awesomebrick/fieldbox/README.md

# fieldbox
Senior design project. FPGA-powered eurorack synthesis and audio processing module
