awesomebrick/fieldbox/hardware/motherboard_pcb/fieldbox/diagram.pdf

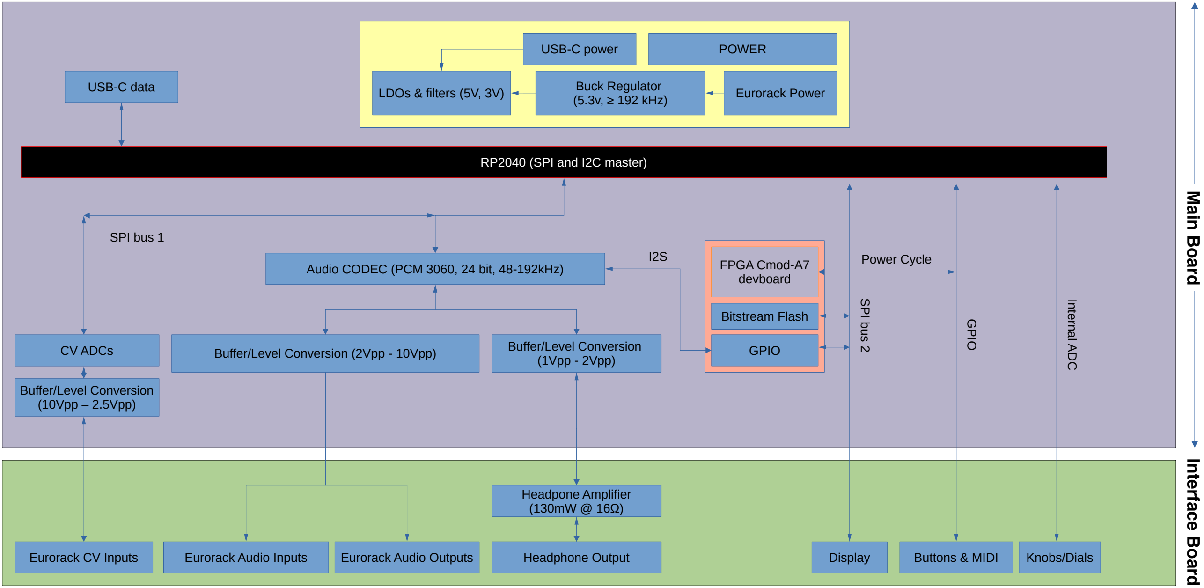
[picture p1: figure]
FPGA Cmod-A7 devboard; GPIO; Bitstream Flash; CV ADCs; Eurorack CV Inputs; Eurorack Audio Inputs; Eurorack Audio Outputs; Headphone Output; Headpone Amplifier (130mW @ 16Ω); USB-C power; Buck Regulator (5.3v, ≥ 192 kHz); LDOs & filters (5V, 3V); USB-C data; Eurorack Power; POWER; Buffer/Level Conversion (1Vpp - 2Vpp); Buffer/Level Conversion (2Vpp - 10Vpp); Display; Buttons & MIDI; Buffer/Level Conversion (10Vpp – 2.5Vpp); RP2040 (SPI and I2C master); SPI bus 1; G PIO; Knobs/Dials; t ern; Power Cycle; M ain

Audio CODEC (PCM 3060, 24 bit, 48-192kHz)
