awesomebrick/fieldbox/hardware/motherboard_pcb/fieldbox/fieldbox.ods

Id | Designator | Footprint | Quantity | Designation | Supplier and ref
1 | R35,R46,R43,R49,R42,R50 | R_0603_1608Metric | 6 | 12k
2 | D1,D2,D5 | D_SMA | 3 | SK34SMA-3G
3 | U2,U23,U18,U21,U1 | TSSOP-14_4.4x5mm_P0.65mm | 5 | TL074
4 | U4 | HTSOP-8-1EP_3.9x4.9mm_P1.27mm_EP2.4x3.2mm | 1 | BD9D321EFJ-E2
5 | C51,C43,C45,C55,C26,C54,C47,C56,C46,C44,C7,C11,C37,C32,C40,C57,C4,C1,C60,C50 | C_0603_1608Metric | 20 | 100nF
6 | D3,D4,D23,D22,D20,D21,D16,D13,D15,D10,D19,D18,D12,D11,D17,D14 | D_SOD-323F | 16 | 1N4148
7 | C66,C64,C23,C21,C39,C30,C53,C31,C34,C27,C62,C28,C61,C38,C35 | C_0603_1608Metric | 15 | 1uF
8 | R20,R16,R13,R10 | R_0603_1608Metric | 4 | 330
9 | C6,C5 | CP_EIA-3216-18_Kemet-A | 2 | 4.7uF
10 | J2 | PinSocket_1x06_P2.54mm_Vertical | 1 | Conn_01x06_Socket
11 | R21,R22,R39 | R_0603_1608Metric | 3 | 1k
12 | U16 | SOIC-8_5.3x5.3mm_P1.27mm | 1 | W25Q16JVSNIM
13 | R23,R52,R40,R31,R32,R24,R41,R51 | R_0603_1608Metric | 8 | 33k
14 | D6,D9,D8,D7 | LED_0603_1608Metric | 4 | RED
15 | R57,R73,R74,R76,R56 | C_0603_1608Metric | 5 | 30k
16 | U20 | TSSOP-20_4.4x6.5mm_P0.65mm | 1 | MCP3462R
17 | U13,U15,U5 | SOT-23-5 | 3 | AP22814BW5
18 | R7 | R_0603_1608Metric | 1 | 330k .1%
19 | R54,R60,R66,R26,R45,R55,R37,R30,R33,R28,R64,R36,R65,R44,R48,R78,R61,R53,R75 | R_0603_1608Metric | 19 | 100k
20 | R83,R80 | R_0603_1608Metric | 2 | 5.62k
21 | C17,C18 | C_0603_1608Metric | 2 | 22uF
22 | U3 | TSSOP-28_4.4x9.7mm_P0.65mm | 1 | PCM3060
23 | R59,R2,R11,R15,R1,R85,R77,R9,R8 | R_0603_1608Metric | 9 | 10k
24 | C16,C14,C12,C20 | C_0603_1608Metric | 4 | 100nF 12v
25 | R6 | R_0603_1608Metric | 1 | 220k .1%
26 | R81,R82,R84,R79 | R_0603_1608Metric | 4 | 2.87k
27 | FB3,FB1,FB2 | L_0603_1608Metric | 3 | MFBM1V1608-600-R
28 | C65,C8,C2,C63,C3,C10,C58,C9 | CP_EIA-3216-18_Kemet-A | 8 | 10uF
29 | C19,C13,C15,C29,C24 | CP_EIA-3528-21_Kemet-B | 5 | 22uF 12v
30 | J1 | PinSocket_1x06_P2.54mm_Vertical | 1 | Conn_01x04_Socket
31 | U27 | OSC-SMD_4P-L2.5-W2.0-BL_ABRACON_ASTMLPD | 1 | ASDDV-12.000MHZ-LC-T
32 | R4,R25,R3 | R_0603_1608Metric | 3 | 10k .1%
33 | J5 | PinSocket_1x04_P2.54mm_Vertical | 1 | Conn_01x04_Socket
34 | R12 | R_0603_1608Metric | 1 | 10.5k
35 | U25 | TSSOP-16-1EP_4.4x5mm_P0.65mm_EP3x3mm | 1 | MAX9722A
36 | R58,R34 | R_0603_1608Metric | 2 | 47.5k
37 | J3 | PinSocket_1x11_P2.54mm_Vertical | 1 | Conn_01x11_Socket
38 | U11 | SON50P250X250X80-11N-D | 1 | TPS7A91
39 | C33 | C_0603_1608Metric | 1 | 100pF
40 | L1 | L_APV_ANR4012 | 1 | 3.3uH
41 | R17,R18 | R_0603_1608Metric | 2 | 27.4
42 | APS6408L-30Cx1 | BGA-24_6x8mm_Layout5x5_P1.0mm | 1 | ~
43 | U19,U22 | DIP-6_W7.62mm | 2 | H11L1M
44 | C22 | C_0603_1608Metric | 1 | 3.3nF
45 | U9,U8 | SOT-23-5 | 2 | AP22814AW5
46 | U10,U26 | SOT-353_SC-70-5 | 2 | 74LVC1G32
47 | U7 | SOT-363_SC-70-6 | 1 | NC7SZ332
48 | JP4 | R_0603_1608Metric | 1 | Jumper_2_Open
49 | U24 | MSOP-8_3x3mm_P0.65mm | 1 | MCP6282
50 | C36,C25 | CP_EIA-3528-21_Kemet-B | 2 | 120uF
51 | U14 | QSOP-20_3.9x8.7mm_P0.635mm | 1 | QS3VH245
52 | R27,R29 | R_0603_1608Metric | 2 | 20k .1%
53 | R38,R47 | R_0603_1608Metric | 2 | 220
54 | U17 | QFN-56-1EP_7x7mm_P0.4mm_EP3.2x3.2mm | 1 | RP2040
55 | U12 | SOIC-8_3.9x4.9mm_P1.27mm | 1 | AP2213M
56 | R5 | R_0603_1608Metric | 1 | 22k .1%
57 | R14 | R_0603_1608Metric | 1 | 2k
58 | U6 | Texas_X2QFN-12_1.6x1.6mm_P0.4mm | 1 | PTN5150A
59 | C41 | C_0603_1608Metric | 1 | .01uF
60 | cmod_a1 | CMOD-A7 | 1 | cmod a7 35t
61 | J4 | IDC-Header_2x05_P2.54mm_Vertical | 1 | Conn_02x05_Odd_Even
