awesomebrick/fieldbox/hardware/motherboard_pcb/fieldbox/try2.ods

Reference | Qty | Description | Mouser #
J1,J2,J3,J5,JP4 | 5 | Generic connector, single row, 01x04, script generated,Generic connector, single row, 01x06, script generated,Generic connector, single row, 01x11, script generated,Jumper, 2-pole, open
U17 | 1 | A microcontroller by Raspberry Pi | 358-SC091413
cmod_a1 | 1 |  | 424-410-328-35
U16 | 1 | 128Mbit / 16MiB Serial Flash Memory, Standard/Dual/Quad SPI, 2.7-3.6V, SOIC-8 | 454-W25Q16JVSNIM
U19,U22 | 2 | Schmitt Trigger Output Optocoupler, High Speed, DIP-6, 1.6mA turn on threshold | 512-H11L1M
U7 | 1 | Logic Gates TinyLogic UHS 3Input | 512-NC7SZ332P6X
C2,C3,C8,C9,C10,C58,C63,C65 | 8 |  | 581-TAJA106K016R
C5,C6 | 2 | Polarized capacitor | 581-TAJA475M006R
C13,C15,C19,C24,C29 | 5 | Polarized capacitor | 581-TAJB226K016TNJ
C25,C36 | 2 | Polarized capacitor | 581-TPSB107M006R0400
U1,U2,U18,U21,U23 | 5 | Quad Low-Noise JFET-Input Operational Amplifiers, DIP-14/SOIC-14 | 595-TL074HIPWR
U11 | 1 | 1A low noise high PSSR LDO | 595-TPS7A9101DSKR
C33 | 1 | Unpolarized capacitor | 603-CC603KRX7R8BB101
C41 | 1 | Unpolarized capacitor | 603-CC603ZRY5V8BB103
R10,R13,R16,R20 | 4 | Resistor | 603-RC0603FR-10330RL
R17,R18 | 2 | Resistor | 603-RC0603FR-0727R4L
U12 | 1 | 3.3v low noise ldo | 621-AP2213M-3.3TRG1
U8,U9 | 2 | Current limited 3A power switch, single channel, SOT-23-5 | 621-AP22814AW5-7
U5,U13,U15 | 3 | Current limited 3A power switch, single channel, SOT-23-5 | 621-AP22814BW5-7
D3,D4,D10,D11,D12,D13,D14,D15,D16,D17,D18,D19,D20,D21,D22,D23 | 16 | 100V 0.15A standard switching diode, DO-35 | 637-1N4148WS-AQ
D1,D2,D5 | 3 | Schottky diode | 637-SK34SMA-3G
R38,R47 | 2 | Resistor | 652-CR0603FX-2200ELF
R79,R81,R82,R84 | 4 | Resistor | 652-CR0603FX-2871ELF
R1,R2,R3,R4,R8,R9,R11,R15,R25,R59,R77,R85 | 12 | Resistor | 652-CRT0603BY1002ELF
R80,R83 | 2 | Resistor | 660-RK73H1JTTD5621F
R21,R22,R39 | 3 | Resistor | 660-RK73H1JTTDD1001F
R56,R57,R73,R74,R76 | 5 | Resistor | 660-RK73H1JTTDD3002F
R14 | 1 | Resistor | 660-RN73H1JTD2001B25
R12 | 1 | Resistor | 667-ERA-3AEB1052V
R34,R58 | 2 | Resistor | 667-ERA-3AEB4752V
U25 | 1 | MAX9722AEUE+T | 700-MAX9722AEUE
FB1,FB2,FB3 | 3 | Ferrite bead | 704-MFBM1V1608-600-R
R27,R29 | 2 | Resistor | 708-RNCF0603BTC20K0
D6,D7,D8,D9 | 4 | Light emitting diode | 720-LSQ976.01-N1Q2-1
J4 | 1 | Generic connector, double row, 02x05, odd/even pin numbering scheme (row 1 odd numbers, row 2 even numbers), script generated (kicad-library-utils/schlib/autogen/connector/) | 737-BHR-10-VUA
R35,R42,R43,R46,R49,R50 | 6 | Resistor | 754-RG1608P-123-B-T5
R5 | 1 | Resistor | 754-RG1608P-223-B-T5
R6 | 1 | Resistor | 754-RG1608P-224-BT5
R7 | 1 | Resistor | 754-RG1608P-334-B-T5
U4 | 1 |  | 755-BD9D321EFJ-E2
U10,U26 | 2 | Single OR Gate, Low-Voltage CMOS | 771-74LVC1G32GW-G
U6 | 1 |  | 771-PTN5150AHXMP
C21,C23,C27,C28,C30,C31,C34,C35,C38,C39,C53,C61,C62,C64,C66 | 15 | Unpolarized capacitor | 791-0201X105M6R3CT
C17,C18 | 2 | Unpolarized capacitor | 81-GRM188R60J226ME5J
U27 | 1 |  | 815-ASDDV-1200MHZLCT
APS6408L-30Cx1 | 1 |  | 878-APS6408L-3OC-BA
L1 | 1 | Inductor | 963-NRS4012T3R3MDGJ
U14 | 1 |  | 972-QS3VH245QG8
C22 | 1 | Unpolarized capacitor | CL10B332KB8NFNC
R26,R28,R30,R33,R36,R37,R44,R45,R48,R53,R54,R55,R60,R61,R64,R65,R66,R75,R78 | 19 | Resistor | CR0603-FX-1003ELF
R23,R24,R31,R32,R40,R41,R51,R52 | 8 | Resistor | CR0603-FX-3302ELF
C1,C4,C7,C11,C12,C14,C16,C20,C26,C32,C37,C40,C43,C44,C45,C46,C47,C50,C51,C54,C55,C56,C57,C60 | 24 | Unpolarized capacitor | KGM15AR71C104MM
U20 | 1 | Analog to Digital Converters - ADC 16-bit delta-sigma ADC w/Vref, Dual channel, 3V | MCP3462R-E/ST
U24 | 1 |  | MCP6282T-E/MS
U3 | 1 | 24-bit Asynchronous Stereo Audio Codec with 96/192kHz sampling rate, TSSOP-28 | PCM3060PWR
