awesomebrick/fieldbox/hardware/motherboard_pcb/fieldbox/fieldbox.kicad_pcb

## KiCad design hardware/motherboard_pcb/fieldbox/fieldbox.kicad_pcb (2026-04-05)

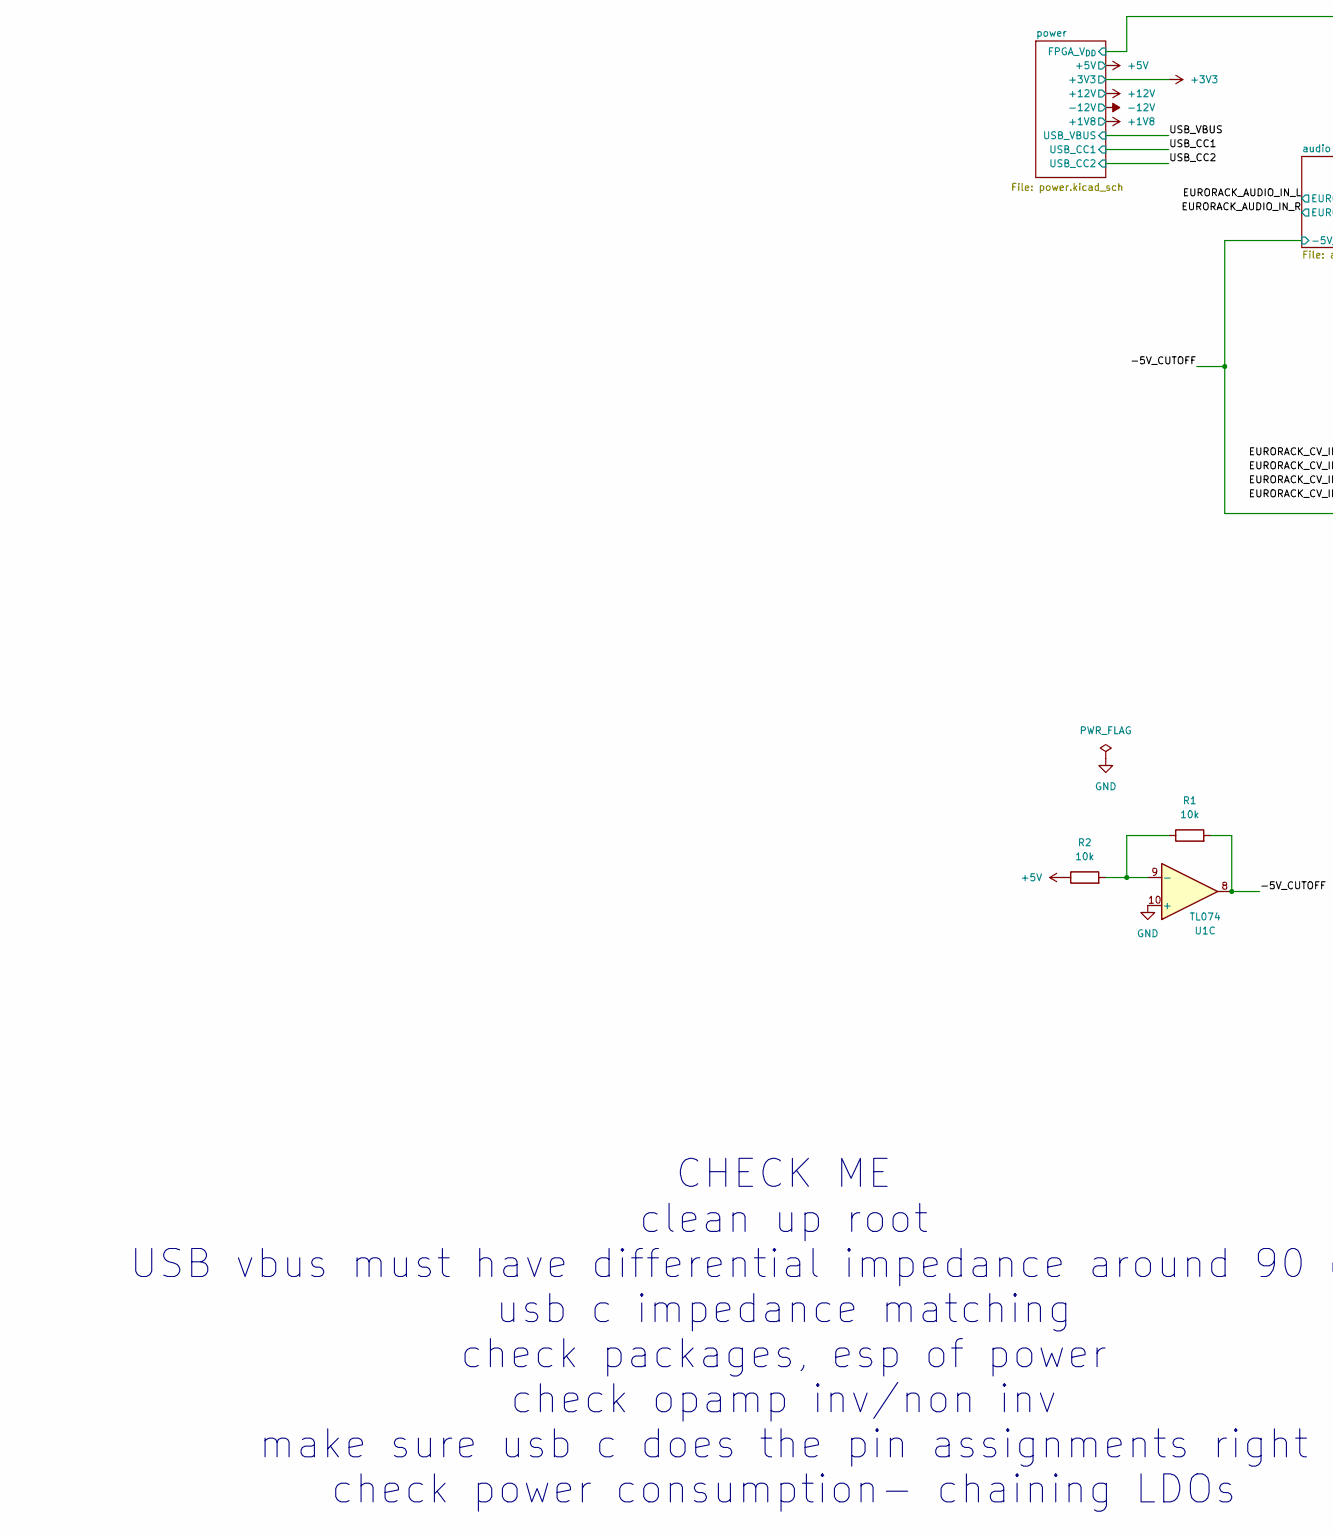
[picture p2: schematic fieldbox.kicad_sch, part in row 1, column 1]

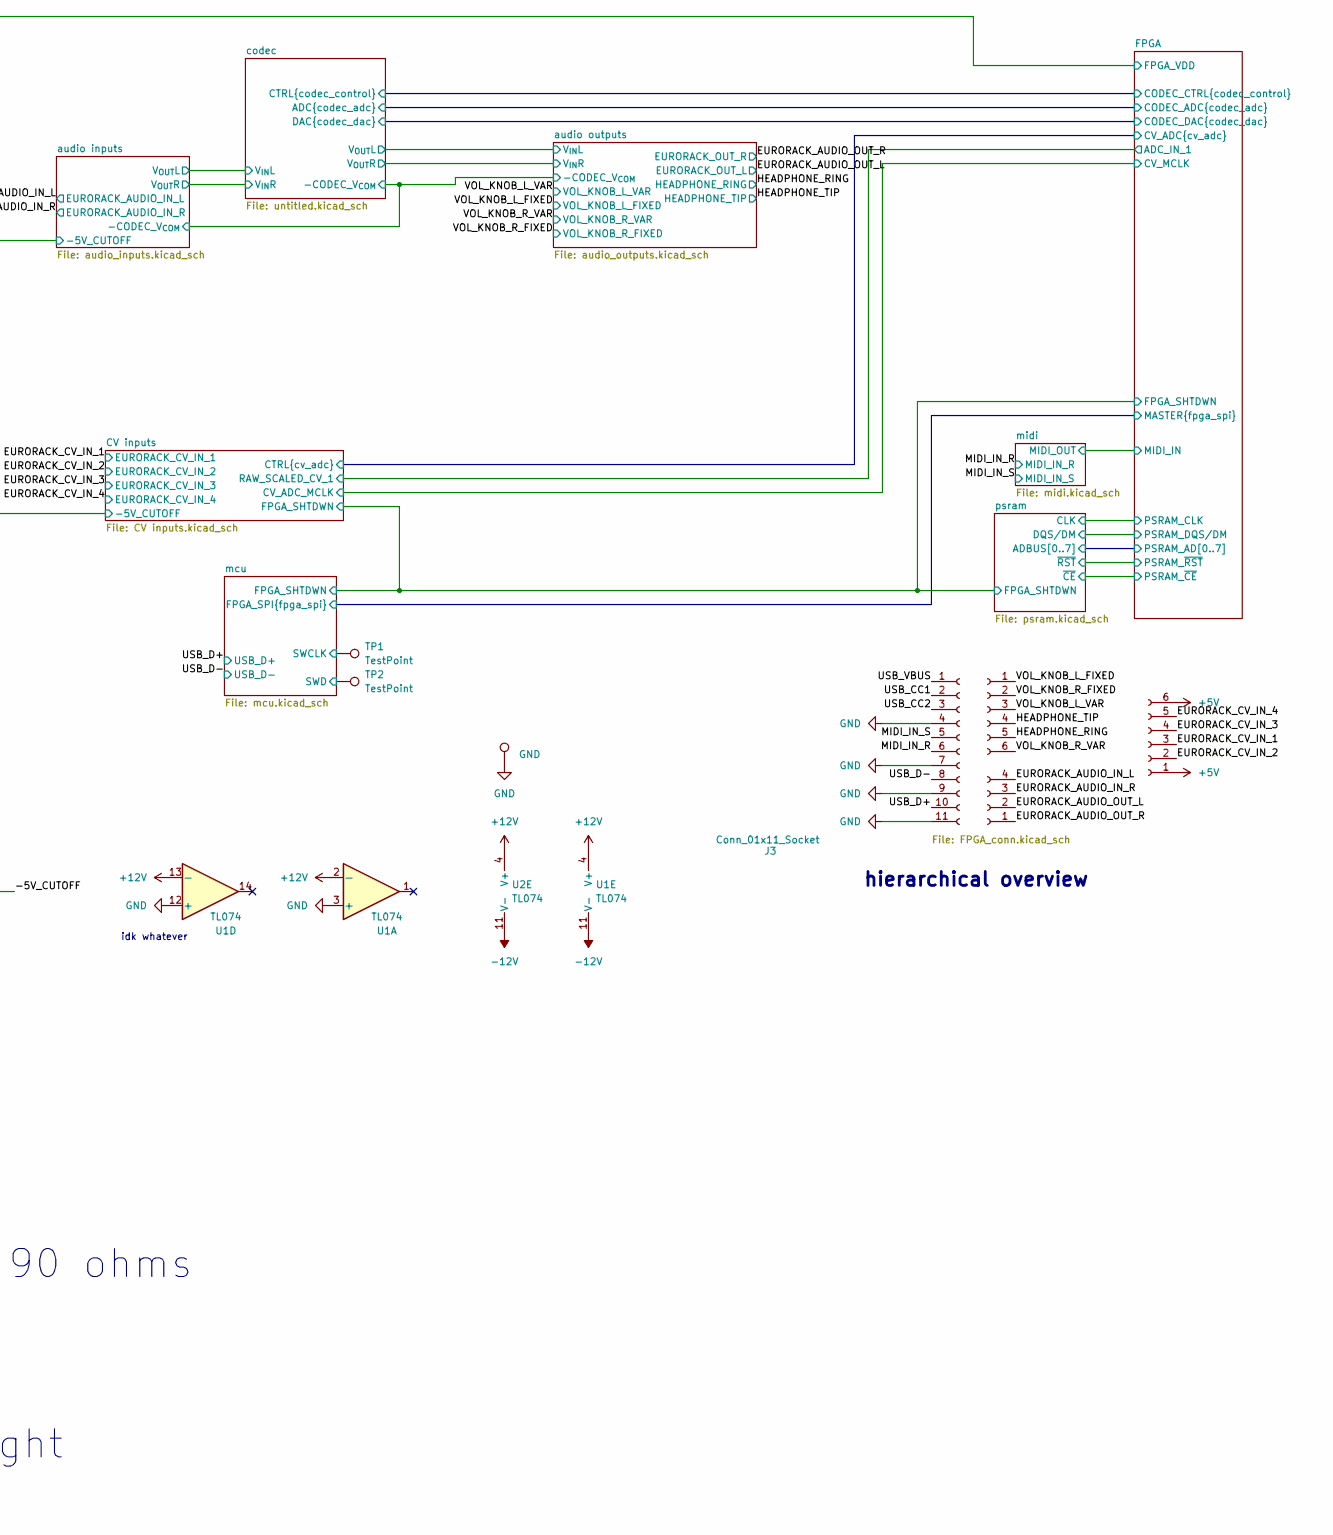
[picture p3: schematic fieldbox.kicad_sch, part in row 1, column 2]

Parts:
J1: Conn_01x04_Socket; PinSocket_1x06_P2.54mm_Vertical
J2: Conn_01x06_Socket; PinSocket_1x06_P2.54mm_Vertical
J3: Conn_01x11_Socket; PinSocket_1x11_P2.54mm_Vertical
J5: Conn_01x04_Socket; PinSocket_1x04_P2.54mm_Vertical
R1, R2: 10k; R_0603_1608Metric; Mouser # 652-CRT0603BY1002ELF
TP1, TP2: TestPoint; TestPoint_Pad_2.0x2.0mm; Mouser # NA
TP3: GND; TestPoint_Pad_D2.0mm; Mouser # NA
U1, U2: TL074; TSSOP-14_4.4x5mm_P0.65mm; Mouser # 595-TL074HIPWR

Connections:
+5V: J1.1, J1.6, R2.1; also elsewhere on the board
+12V: U1.2 (-), U1.4 (V+), U1.13 (-), U2.4 (V+); also elsewhere on the board
-12V: U1.11 (V-), U2.11 (V-); also elsewhere on the board
/-5V_CUTOFF: R1.2, U1.8; also elsewhere on the board
/EURORACK_AUDIO_IN_L: J5.4; also elsewhere on the board
/EURORACK_AUDIO_IN_R: J5.3; also elsewhere on the board
/EURORACK_AUDIO_OUT_L: J5.2; also elsewhere on the board
/EURORACK_AUDIO_OUT_R: J5.1; also elsewhere on the board
/EURORACK_CV_IN_1: J1.3; also elsewhere on the board
/EURORACK_CV_IN_2: J1.2; also elsewhere on the board
/EURORACK_CV_IN_3: J1.4; also elsewhere on the board
/EURORACK_CV_IN_4: J1.5; also elsewhere on the board
/HEADPHONE_RING: J2.5; also elsewhere on the board
/HEADPHONE_TIP: J2.4; also elsewhere on the board
/MIDI_IN_R: J3.6; also elsewhere on the board
/MIDI_IN_S: J3.5; also elsewhere on the board
/USB_CC1: J3.2; also elsewhere on the board
/USB_CC2: J3.3; also elsewhere on the board
/USB_D+: J3.10; also elsewhere on the board
/USB_D-: J3.8; also elsewhere on the board
/USB_VBUS: J3.1; also elsewhere on the board
/VOL_KNOB_L_FIXED: J2.1; also elsewhere on the board
/VOL_KNOB_L_VAR: J2.3; also elsewhere on the board
/VOL_KNOB_R_FIXED: J2.2; also elsewhere on the board
/VOL_KNOB_R_VAR: J2.6; also elsewhere on the board
/mcu/SWCLK: TP1.1; also elsewhere on the board
/mcu/SWD: TP2.1; also elsewhere on the board
GND: J3.4, J3.7, J3.9, J3.11, TP3.1, U1.3 (+), U1.10 (+), U1.12 (+); also elsewhere on the board
unnamed: R1.1, R2.2, U1.9 (-)

Notes on the sheet:
hierarchical overview
CHECK ME clean up root USB vbus must have differential impedance around 90 ohms usb c impedance matching check packages, esp of power check opamp inv/non inv make sure usb c does the pin assignments right check power consumption- chaining LDOs
idk whatever

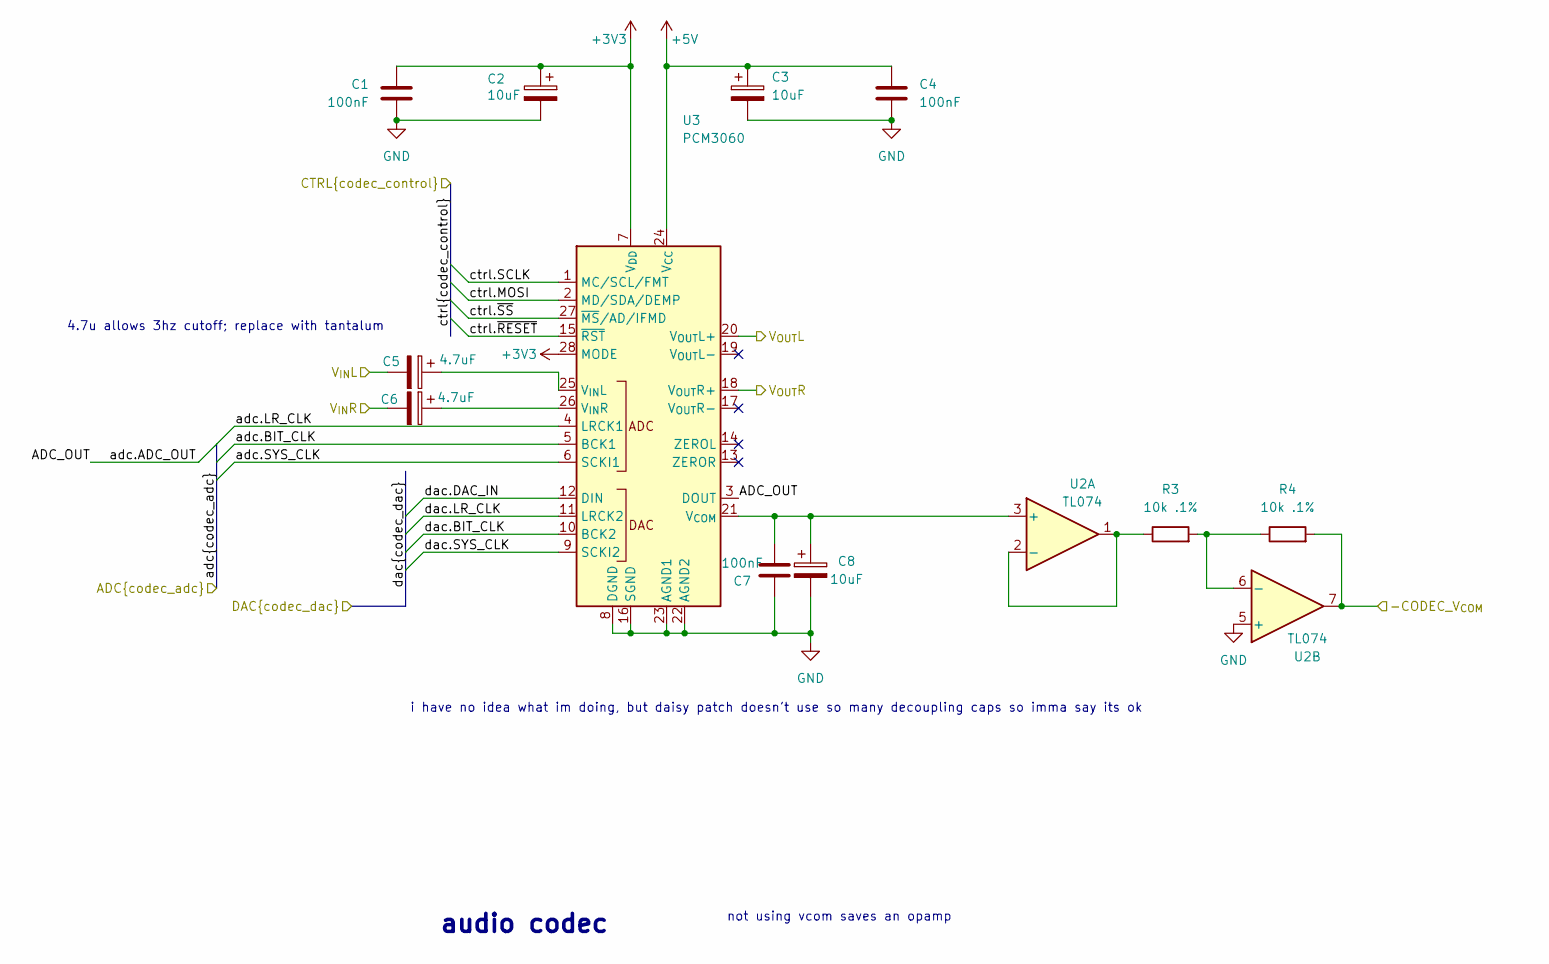
[picture p4: schematic untitled.kicad_sch]

Parts:
C1, C4, C7: 100nF; C_0603_1608Metric; Mouser # KGM15AR71C104MM
C2, C3, C8: 10uF; CP_EIA-3216-18_Kemet-A; Mouser # 581-TAJA106K016R
C5, C6: 4.7uF; CP_EIA-3216-18_Kemet-A; Mouser # 581-TAJA475M006R
R3, R4: 10k .1%; R_0603_1608Metric; Mouser # 652-CRT0603BY1002ELF
U2: TL074; TSSOP-14_4.4x5mm_P0.65mm; Mouser # 595-TL074HIPWR
U3: PCM3060; TSSOP-28_4.4x9.7mm_P0.65mm; Mouser # PCM3060PWR

Connections:
+3V3: C1.1, C2.1, U3.7 (V_{DD}), U3.28 (MODE); also elsewhere on the board
+5V: C3.1, C4.1, U3.24 (V_{CC}); also elsewhere on the board
/FPGA/CODEC_ADC.ADC_OUT: U3.3 (DOUT); also elsewhere on the board
/FPGA/CODEC_ADC.BIT_CLK: U3.5 (BCK1); also elsewhere on the board
/FPGA/CODEC_ADC.LR_CLK: U3.4 (LRCK1); also elsewhere on the board
/FPGA/CODEC_ADC.SYS_CLK: U3.6 (SCKI1); also elsewhere on the board
/FPGA/CODEC_CTRL.MOSI: U3.2 (MD/SDA/DEMP); also elsewhere on the board
/FPGA/CODEC_CTRL.SCLK: U3.1 (MC/SCL/FMT); also elsewhere on the board
/FPGA/CODEC_CTRL.~RESET: U3.15 (~RST); also elsewhere on the board
/FPGA/CODEC_CTRL.~SS: U3.27 (~MS/AD/IFMD); also elsewhere on the board
/FPGA/CODEC_DAC.BIT_CLK: U3.10 (BCK2); also elsewhere on the board
/FPGA/CODEC_DAC.DAC_IN: U3.12 (DIN); also elsewhere on the board
/FPGA/CODEC_DAC.LR_CLK: U3.11 (LRCK2); also elsewhere on the board
/FPGA/CODEC_DAC.SYS_CLK: U3.9 (SCKI2); also elsewhere on the board
/audio inputs/-CODEC_V_{COM}: R4.2, U2.7; also elsewhere on the board
/audio inputs/V_{OUT}L: C5.2; also elsewhere on the board
/audio inputs/V_{OUT}R: C6.2; also elsewhere on the board
/audio outputs/V_{IN}L: U3.20 (V_{OUT}L+); also elsewhere on the board
/audio outputs/V_{IN}R: U3.18 (V_{OUT}R+); also elsewhere on the board
GND: C1.2, C2.2, C3.2, C4.2, C7.1, C8.2, U2.5 (+), U3.8 (DGND), U3.16 (SGND), U3.22 (AGND2), U3.23 (AGND1); also elsewhere on the board
unnamed: C7.2, C8.1, U2.3 (+), U3.21 (V_{COM})
unnamed: R3.1, U2.1, U2.2 (-)
unnamed: R3.2, R4.1, U2.6 (-)
unnamed: C5.1, U3.25 (V_{IN}L)
unnamed: C6.1, U3.26 (V_{IN}R)

Notes on the sheet:
i have no idea what im doing, but daisy patch doesn't use so many decoupling caps so imma say its ok
4.7u allows 3hz cutoff; replace with tantalum
not using vcom saves an opamp
audio codec

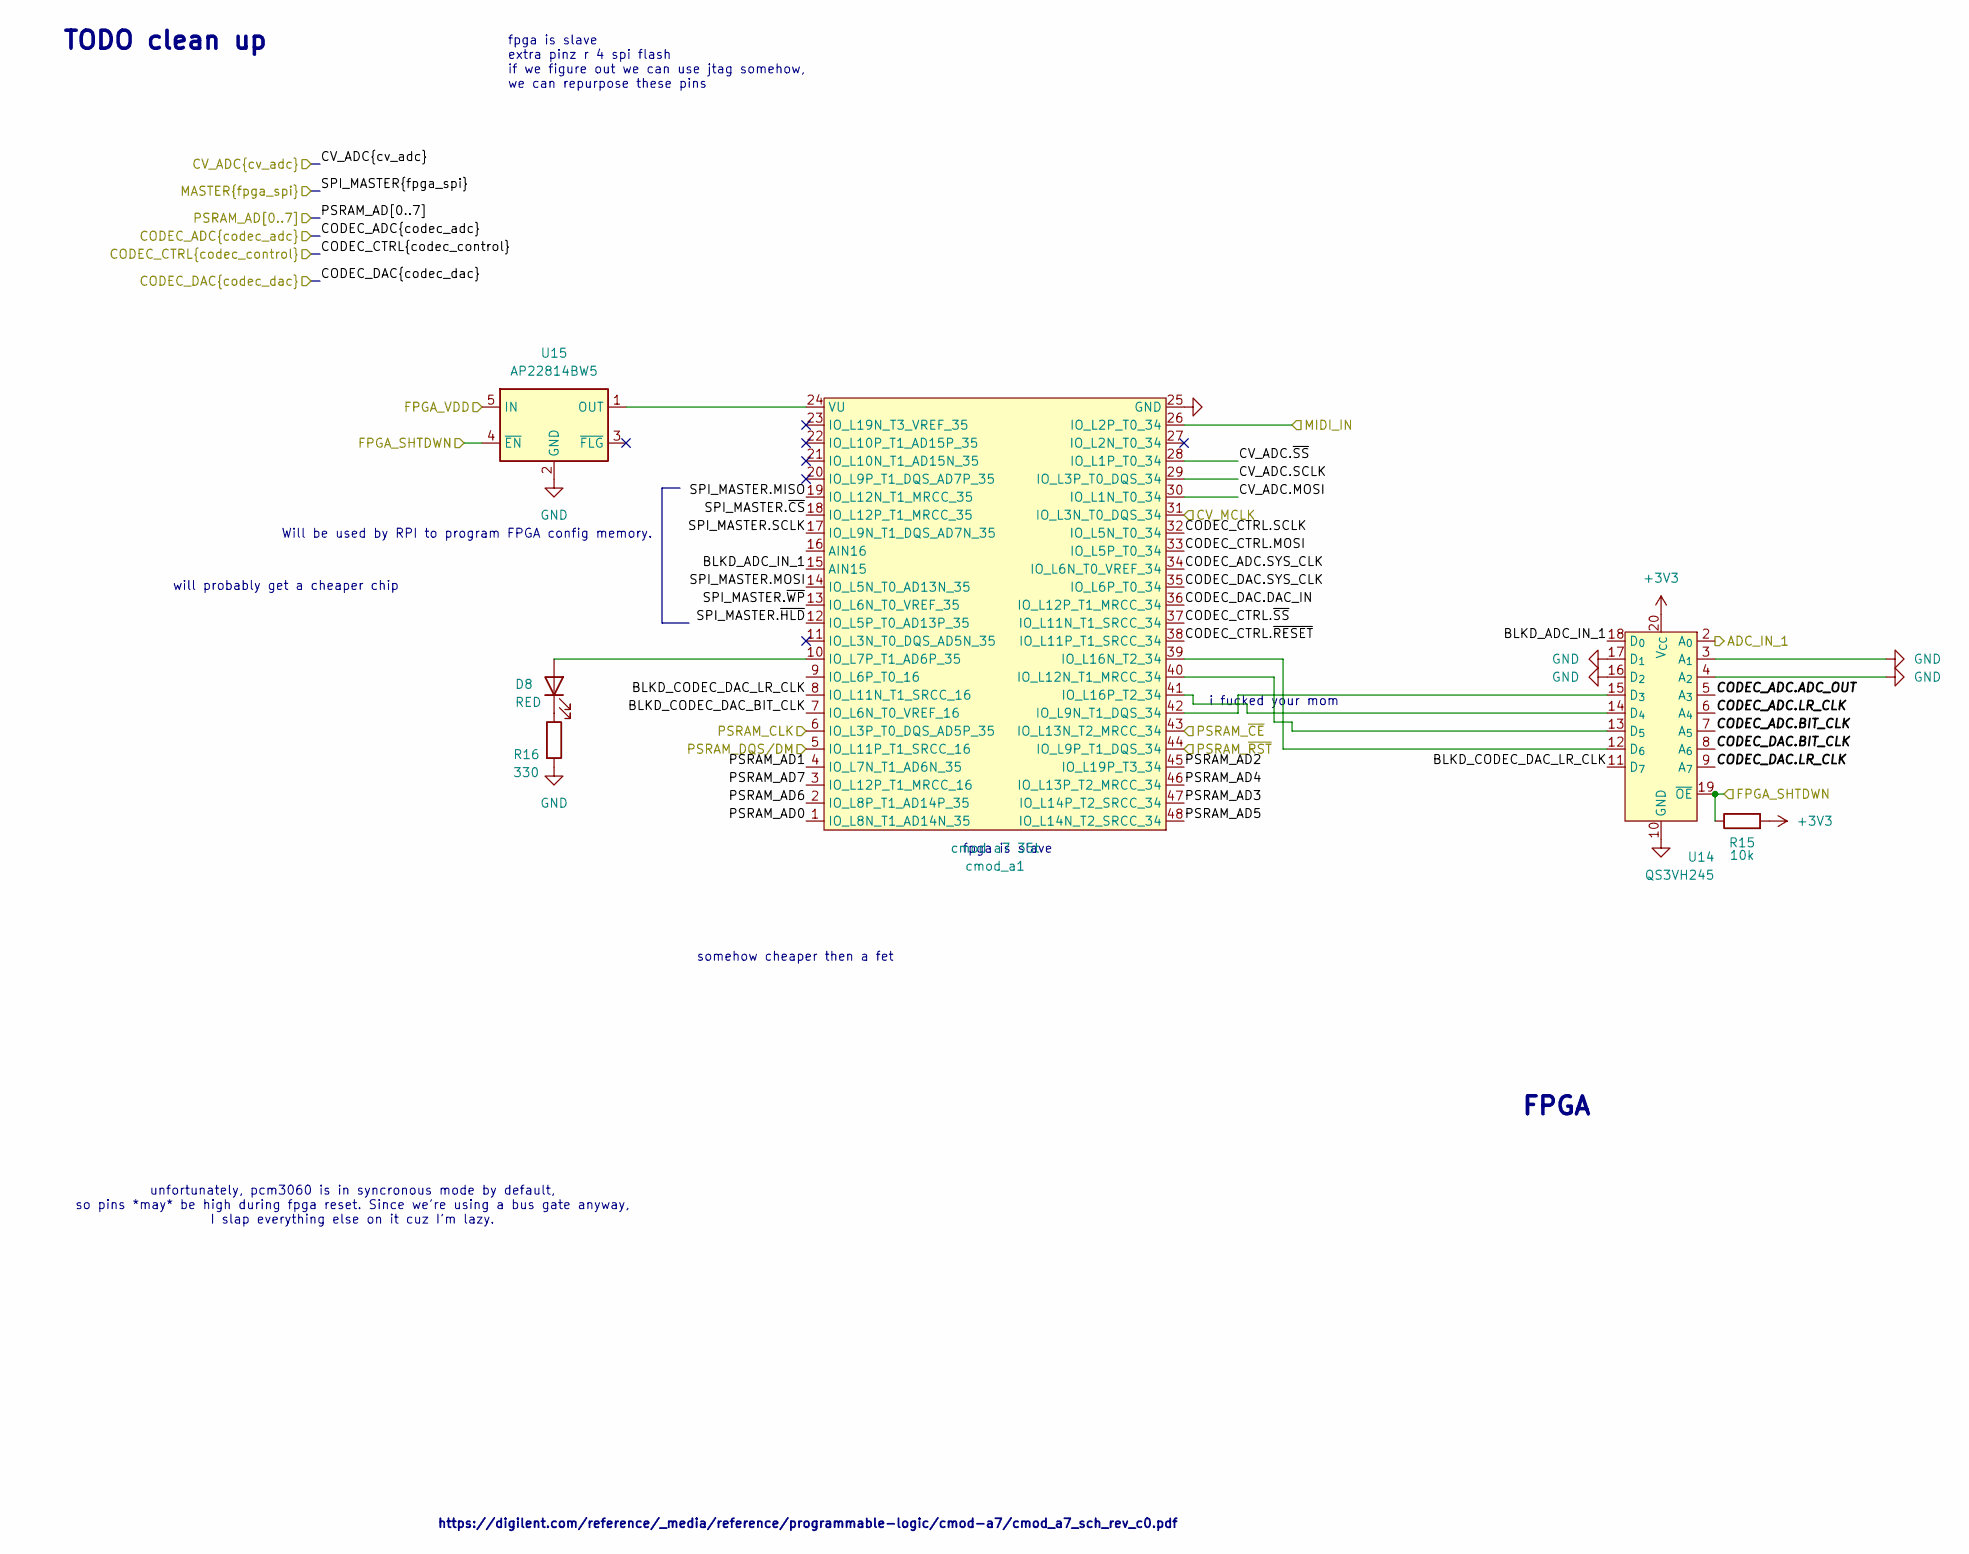
[picture p5: schematic FPGA_conn.kicad_sch]

Parts:
D8: RED; LED_0603_1608Metric; Mouser # 720-LSQ976.01-N1Q2-1
R15: 10k; R_0603_1608Metric; Mouser # 652-CRT0603BY1002ELF
R16: 330; R_0603_1608Metric; Mouser # 603-RC0603FR-10330RL
U14: QS3VH245; QSOP-20_3.9x8.7mm_P0.635mm; Mouser # 972-QS3VH245QG8
U15: AP22814BW5; SOT-23-5; Mouser # 621-AP22814BW5-7
cmod_a1: cmod a7 35t; CMOD-A7; Mouser # 424-410-328-35

Connections:
+3V3: R15.2, U14.20 (V_{CC}); also elsewhere on the board
/CV inputs/CV_ADC_MCLK: cmod_a1.31 (IO_L3N_T0_DQS_34); also elsewhere on the board
/CV inputs/FPGA_SHTDWN: R15.1, U14.19 (~OE), U15.4 (~EN); also elsewhere on the board
/CV inputs/RAW_SCALED_CV_1: U14.2 (A_{0}); also elsewhere on the board
/CV inputs/adc.MOSI: cmod_a1.30 (IO_L1N_T0_34); also elsewhere on the board
/CV inputs/adc.SCLK: cmod_a1.29 (IO_L3P_T0_DQS_34); also elsewhere on the board
/CV inputs/adc.~SS: cmod_a1.28 (IO_L1P_T0_34); also elsewhere on the board
/FPGA/BLKD_ADC_IN_1: U14.18 (D_{0}), cmod_a1.15 (AIN15)
/FPGA/BLKD_CODEC_DAC_BIT_CLK: cmod_a1.7 (IO_L6N_T0_VREF_16)
/FPGA/BLKD_CODEC_DAC_LR_CLK: U14.11 (D_{7}), cmod_a1.8 (IO_L11N_T1_SRCC_16)
/FPGA/CODEC_ADC.ADC_OUT: U14.5 (A_{3}); also elsewhere on the board
/FPGA/CODEC_ADC.BIT_CLK: U14.7 (A_{5}); also elsewhere on the board
/FPGA/CODEC_ADC.LR_CLK: U14.6 (A_{4}); also elsewhere on the board
/FPGA/CODEC_ADC.SYS_CLK: cmod_a1.34 (IO_L6N_T0_VREF_34); also elsewhere on the board
/FPGA/CODEC_CTRL.MOSI: cmod_a1.33 (IO_L5P_T0_34); also elsewhere on the board
/FPGA/CODEC_CTRL.SCLK: cmod_a1.32 (IO_L5N_T0_34); also elsewhere on the board
/FPGA/CODEC_CTRL.~RESET: cmod_a1.38 (IO_L11P_T1_SRCC_34); also elsewhere on the board
/FPGA/CODEC_CTRL.~SS: cmod_a1.37 (IO_L11N_T1_SRCC_34); also elsewhere on the board
/FPGA/CODEC_DAC.BIT_CLK: U14.8 (A_{6}); also elsewhere on the board
/FPGA/CODEC_DAC.DAC_IN: cmod_a1.36 (IO_L12P_T1_MRCC_34); also elsewhere on the board
/FPGA/CODEC_DAC.LR_CLK: U14.9 (A_{7}); also elsewhere on the board
/FPGA/CODEC_DAC.SYS_CLK: cmod_a1.35 (IO_L6P_T0_34); also elsewhere on the board
/FPGA/FPGA_VDD: U15.5 (IN); also elsewhere on the board
/FPGA/MIDI_IN: cmod_a1.26 (IO_L2P_T0_34); also elsewhere on the board
/FPGA/PSRAM_AD0: cmod_a1.1 (IO_L8N_T1_AD14N_35); also elsewhere on the board
/FPGA/PSRAM_AD1: cmod_a1.4 (IO_L7N_T1_AD6N_35); also elsewhere on the board
/FPGA/PSRAM_AD2: cmod_a1.45 (IO_L19P_T3_34); also elsewhere on the board
/FPGA/PSRAM_AD3: cmod_a1.47 (IO_L14P_T2_SRCC_34); also elsewhere on the board
/FPGA/PSRAM_AD4: cmod_a1.46 (IO_L13P_T2_MRCC_34); also elsewhere on the board
/FPGA/PSRAM_AD5: cmod_a1.48 (IO_L14N_T2_SRCC_34); also elsewhere on the board
/FPGA/PSRAM_AD6: cmod_a1.2 (IO_L8P_T1_AD14P_35); also elsewhere on the board
/FPGA/PSRAM_AD7: cmod_a1.3 (IO_L12P_T1_MRCC_16); also elsewhere on the board
/FPGA/PSRAM_CLK: cmod_a1.6 (IO_L3P_T0_DQS_AD5P_35); also elsewhere on the board
/FPGA/PSRAM_DQS/DM: cmod_a1.5 (IO_L11P_T1_SRCC_16); also elsewhere on the board
/FPGA/PSRAM_~CE: cmod_a1.43 (IO_L13N_T2_MRCC_34); also elsewhere on the board
/FPGA/PSRAM_~RST: cmod_a1.44 (IO_L9P_T1_DQS_34); also elsewhere on the board
/FPGA/SPI_MASTER.MISO: cmod_a1.19 (IO_L12N_T1_MRCC_35); also elsewhere on the board
/FPGA/SPI_MASTER.MOSI: cmod_a1.14 (IO_L5N_T0_AD13N_35); also elsewhere on the board
/FPGA/SPI_MASTER.SCLK: cmod_a1.17 (IO_L9N_T1_DQS_AD7N_35); also elsewhere on the board
/FPGA/SPI_MASTER.~CS: cmod_a1.18 (IO_L12P_T1_MRCC_35); also elsewhere on the board
/FPGA/SPI_MASTER.~HLD: cmod_a1.12 (IO_L5P_T0_AD13P_35); also elsewhere on the board
/FPGA/SPI_MASTER.~WP: cmod_a1.13 (IO_L6N_T0_VREF_35); also elsewhere on the board
GND: R16.2, U14.3 (A_{1}), U14.4 (A_{2}), U14.10 (GND), U14.16 (D_{2}), U14.17 (D_{1}), U15.2 (GND), cmod_a1.25 (GND); also elsewhere on the board
unnamed: D8.2 (A), cmod_a1.10 (IO_L7P_T1_AD6P_35)
unnamed: D8.1 (K), R16.1
unnamed: U14.15 (D_{3}), cmod_a1.42 (IO_L9N_T1_DQS_34)
unnamed: U14.14 (D_{4}), cmod_a1.41 (IO_L16P_T2_34)
unnamed: U14.13 (D_{5}), cmod_a1.40 (IO_L12N_T1_MRCC_34)
unnamed: U14.12 (D_{6}), cmod_a1.39 (IO_L16N_T2_34)
unnamed: U15.1 (OUT), cmod_a1.24 (VU)

Notes on the sheet:
unfortunately, pcm3060 is in syncronous mode by default, so pins *may* be high during fpga reset. Since we're using a bus gate anyway, I slap everything else on it cuz I'm lazy.
fpga is slave
fpga is slave extra pinz r 4 spi flash if we figure out we can use jtag somehow, we can repurpose these pins
FPGA
TODO clean up
https://digilent.com/reference/_media/reference/programmable-logic/cmod-a7/cmod_a7_sch_rev_c0.pdf
will probably get a cheaper chip
Will be used by RPI to program FPGA config memory.
i fucked your mom
somehow cheaper then a fet

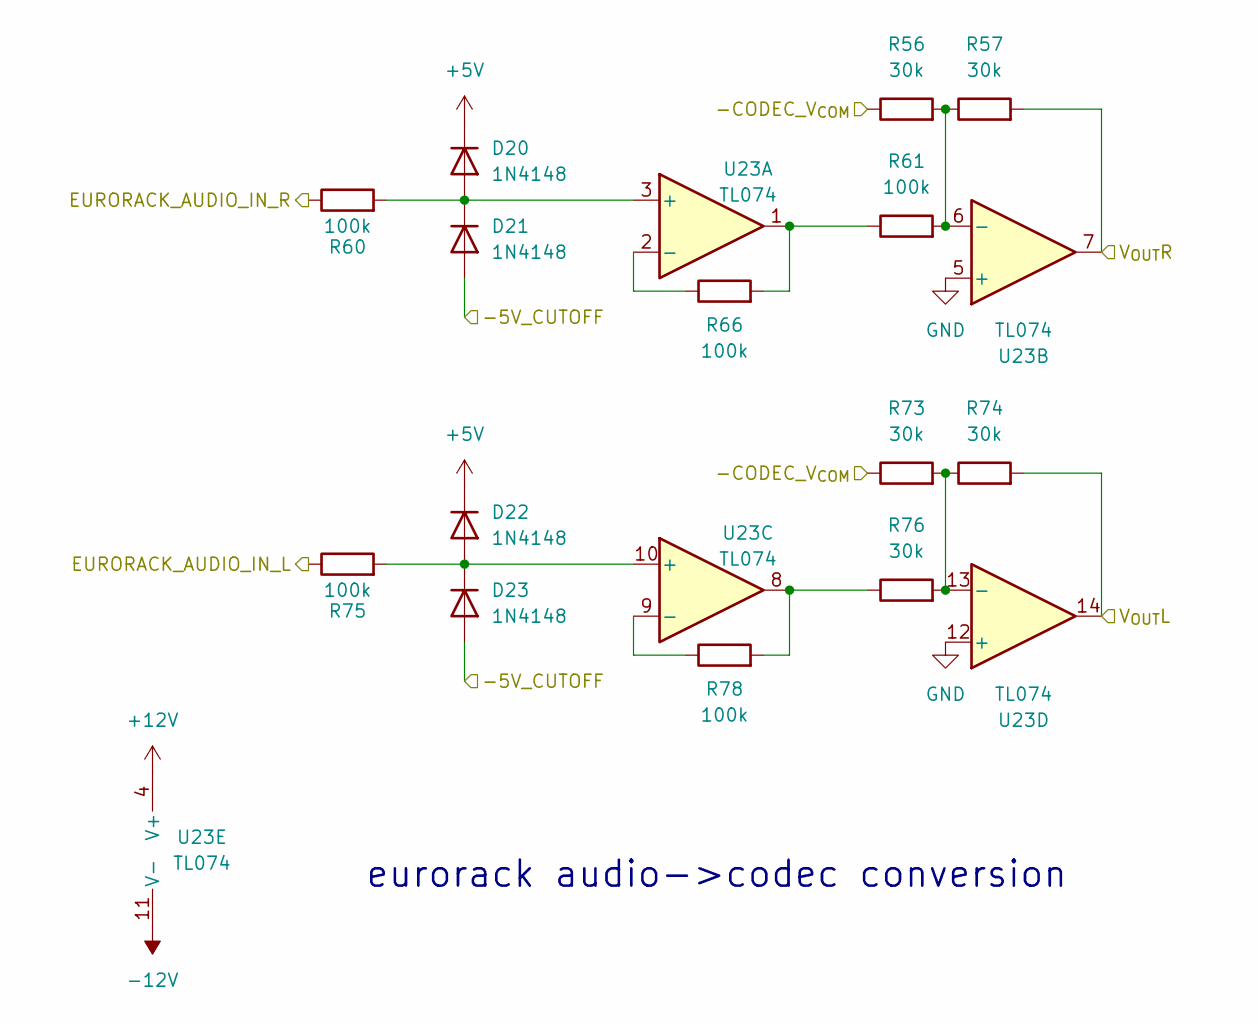
[picture p6: schematic audio_inputs.kicad_sch]

Parts:
D20, D21, D22, D23: 1N4148; D_SOD-323F; Mouser # 637-1N4148WS-AQ
R56, R57, R73, R74, R76: 30k; C_0603_1608Metric; Mouser # 660-RK73H1JTTDD3002F
R60, R61, R66, R75, R78: 100k; R_0603_1608Metric; Mouser # CR0603-FX-1003ELF
U23: TL074; TSSOP-14_4.4x5mm_P0.65mm; Mouser # 595-TL074HIPWR

Connections:
+5V: D20.1 (K), D22.1 (K); also elsewhere on the board
+12V: U23.4 (V+); also elsewhere on the board
-12V: U23.11 (V-); also elsewhere on the board
/-5V_CUTOFF: D21.2 (A), D23.2 (A); also elsewhere on the board
/EURORACK_AUDIO_IN_L: R75.1; also elsewhere on the board
/EURORACK_AUDIO_IN_R: R60.1; also elsewhere on the board
/audio inputs/-CODEC_V_{COM}: R56.1, R73.1; also elsewhere on the board
/audio inputs/V_{OUT}L: R74.2, U23.14; also elsewhere on the board
/audio inputs/V_{OUT}R: R57.2, U23.7; also elsewhere on the board
GND: U23.5 (+), U23.12 (+); also elsewhere on the board
unnamed: D20.2 (A), D21.1 (K), R60.2, U23.3 (+)
unnamed: D22.2 (A), D23.1 (K), R75.2, U23.10 (+)
unnamed: R61.1, R66.2, U23.1
unnamed: R76.1, R78.2, U23.8
unnamed: R66.1, U23.2 (-)
unnamed: R56.2, R57.1, R61.2, U23.6 (-)
unnamed: R78.1, U23.9 (-)
unnamed: R73.2, R74.1, R76.2, U23.13 (-)

Notes on the sheet:
eurorack audio->codec conversion

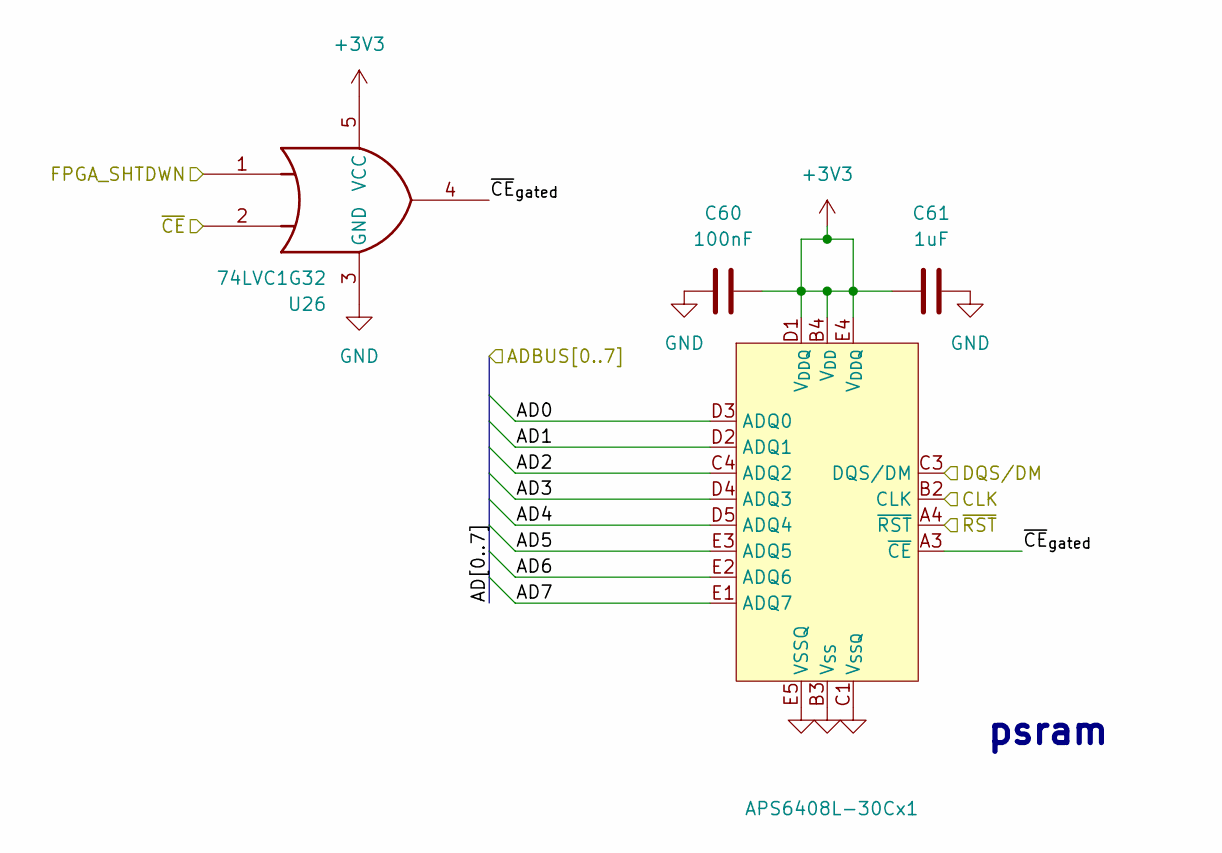
[picture p7: schematic psram.kicad_sch]

Parts:
APS6408L-30Cx1: BGA-24_6x8mm_Layout5x5_P1.0mm; Mouser # 878-APS6408L-3OC-BA
C60: 100nF; C_0603_1608Metric; Mouser # KGM15AR71C104MM
C61: 1uF; C_0603_1608Metric; Mouser # 791-0201X105M6R3CT
U26: 74LVC1G32; SOT-353_SC-70-5; Mouser # 771-74LVC1G32GW-G

Connections:
+3V3: APS6408L-30Cx1.B4 (V_{DD}), APS6408L-30Cx1.D1 (V_{DDQ}), APS6408L-30Cx1.E4 (V_{DDQ}), C60.2, C61.1, U26.5 (VCC); also elsewhere on the board
/CV inputs/FPGA_SHTDWN: U26.1; also elsewhere on the board
/FPGA/PSRAM_AD0: APS6408L-30Cx1.D3 (ADQ0); also elsewhere on the board
/FPGA/PSRAM_AD1: APS6408L-30Cx1.D2 (ADQ1); also elsewhere on the board
/FPGA/PSRAM_AD2: APS6408L-30Cx1.C4 (ADQ2); also elsewhere on the board
/FPGA/PSRAM_AD3: APS6408L-30Cx1.D4 (ADQ3); also elsewhere on the board
/FPGA/PSRAM_AD4: APS6408L-30Cx1.D5 (ADQ4); also elsewhere on the board
/FPGA/PSRAM_AD5: APS6408L-30Cx1.E3 (ADQ5); also elsewhere on the board
/FPGA/PSRAM_AD6: APS6408L-30Cx1.E2 (ADQ6); also elsewhere on the board
/FPGA/PSRAM_AD7: APS6408L-30Cx1.E1 (ADQ7); also elsewhere on the board
/FPGA/PSRAM_CLK: APS6408L-30Cx1.B2 (CLK); also elsewhere on the board
/FPGA/PSRAM_DQS/DM: APS6408L-30Cx1.C3 (DQS/DM); also elsewhere on the board
/FPGA/PSRAM_~CE: U26.2; also elsewhere on the board
/FPGA/PSRAM_~RST: APS6408L-30Cx1.A4 (~RST); also elsewhere on the board
/psram/~CE_{gated}: APS6408L-30Cx1.A3 (~CE), U26.4
GND: APS6408L-30Cx1.B3 (V_{SS}), APS6408L-30Cx1.C1 (V_{SSQ}), APS6408L-30Cx1.E5 (VSSQ), C60.1, C61.2, U26.3 (GND); also elsewhere on the board

Notes on the sheet:
psram

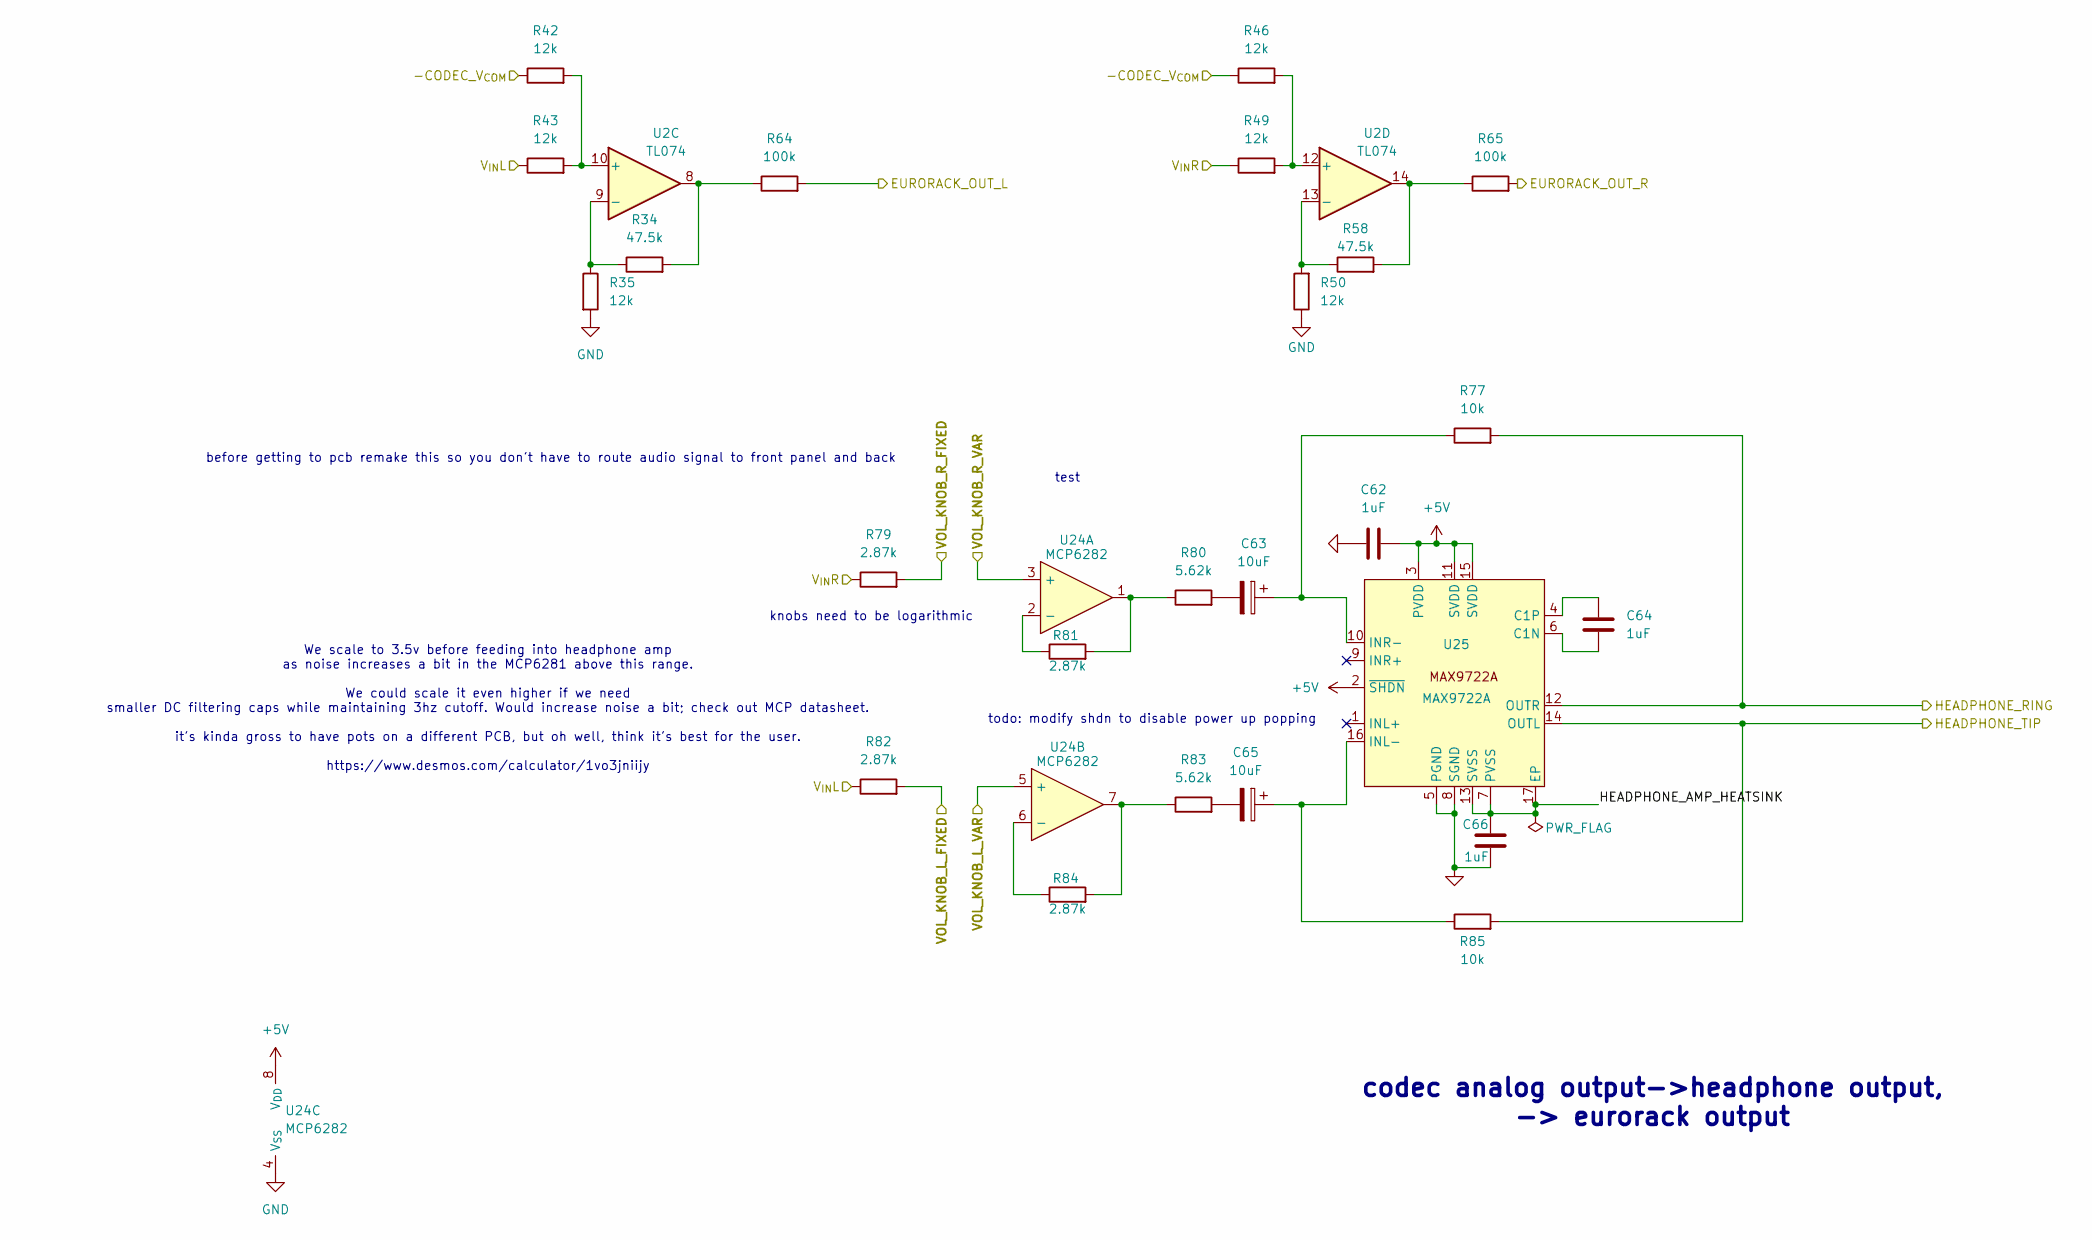
[picture p8: schematic audio_outputs.kicad_sch]

Parts:
C62, C64, C66: 1uF; C_0603_1608Metric; Mouser # 791-0201X105M6R3CT
C63, C65: 10uF; CP_EIA-3216-18_Kemet-A; Mouser # 581-TAJA106K016R
R34, R58: 47.5k; R_0603_1608Metric; Mouser # 667-ERA-3AEB4752V
R35, R42, R43, R46, R49, R50: 12k; R_0603_1608Metric; Mouser # 754-RG1608P-123-B-T5
R64, R65: 100k; R_0603_1608Metric; Mouser # CR0603-FX-1003ELF
R77, R85: 10k; R_0603_1608Metric; Mouser # 652-CRT0603BY1002ELF
R79, R81, R82, R84: 2.87k; R_0603_1608Metric; Mouser # 652-CR0603FX-2871ELF
R80, R83: 5.62k; R_0603_1608Metric; Mouser # 660-RK73H1JTTD5621F
U2: TL074; TSSOP-14_4.4x5mm_P0.65mm; Mouser # 595-TL074HIPWR
U24: MCP6282; MSOP-8_3x3mm_P0.65mm; Mouser # MCP6282T-E/MS
U25: MAX9722A; TSSOP-16-1EP_4.4x5mm_P0.65mm_EP3x3mm; Mouser # 700-MAX9722AEUE

Connections:
+5V: C62.2, U24.8 (V_{DD}), U25.2 (~SHDN), U25.3 (PVDD), U25.11 (SVDD), U25.15 (SVDD); also elsewhere on the board
/EURORACK_AUDIO_OUT_L: R64.2; also elsewhere on the board
/EURORACK_AUDIO_OUT_R: R65.2; also elsewhere on the board
/HEADPHONE_RING: R77.2, U25.12 (OUTR); also elsewhere on the board
/HEADPHONE_TIP: R85.2, U25.14 (OUTL); also elsewhere on the board
/VOL_KNOB_L_FIXED: R82.2; also elsewhere on the board
/VOL_KNOB_L_VAR: U24.5 (+); also elsewhere on the board
/VOL_KNOB_R_FIXED: R79.2; also elsewhere on the board
/VOL_KNOB_R_VAR: U24.3 (+); also elsewhere on the board
/audio inputs/-CODEC_V_{COM}: R42.1, R46.1; also elsewhere on the board
/audio outputs/HEADPHONE_AMP_HEATSINK: C66.1, U25.7 (PVSS), U25.13 (SVSS), U25.17 (EP)
/audio outputs/V_{IN}L: R43.1, R82.1; also elsewhere on the board
/audio outputs/V_{IN}R: R49.1, R79.1; also elsewhere on the board
GND: C62.1, C66.2, R35.2, R50.1, U24.4 (V_{SS}), U25.5 (PGND), U25.8 (SGND); also elsewhere on the board
unnamed: C63.2, R80.2
unnamed: C65.2, R83.2
unnamed: R34.2, R64.1, U2.8
unnamed: R58.2, R65.1, U2.14
unnamed: R80.1, R81.2, U24.1
unnamed: R83.1, R84.2, U24.7
unnamed: R42.2, R43.2, U2.10 (+)
unnamed: R34.1, R35.1, U2.9 (-)
unnamed: R46.2, R49.2, U2.12 (+)
unnamed: R50.2, R58.1, U2.13 (-)
unnamed: R81.1, U24.2 (-)
unnamed: R84.1, U24.6 (-)
unnamed: C64.2, U25.6 (C1N)
unnamed: C64.1, U25.4 (C1P)
unnamed: C65.1, R85.1, U25.16 (INL-)
unnamed: C63.1, R77.1, U25.10 (INR-)

Notes on the sheet:
codec analog output->headphone output, -> eurorack output
todo: modify shdn to disable power up popping
knobs need to be logarithmic
We scale to 3.5v before feeding into headphone amp as noise increases a bit in the MCP6281 above this range. We could scale it even higher if we need smaller DC filtering caps while maintaining 3hz cutoff. Would increase noise a bit; check out MCP datasheet. it's kinda gross to have pots on a diffe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
test
before getting to pcb remake this so you don't have to route audio signal to front panel and back
