awesomebrick/fieldbox/hardware/motherboard_pcb/fieldbox/fieldbox.kicad_pcb

## KiCad design hardware/motherboard_pcb/fieldbox/fieldbox.kicad_pcb (continued)

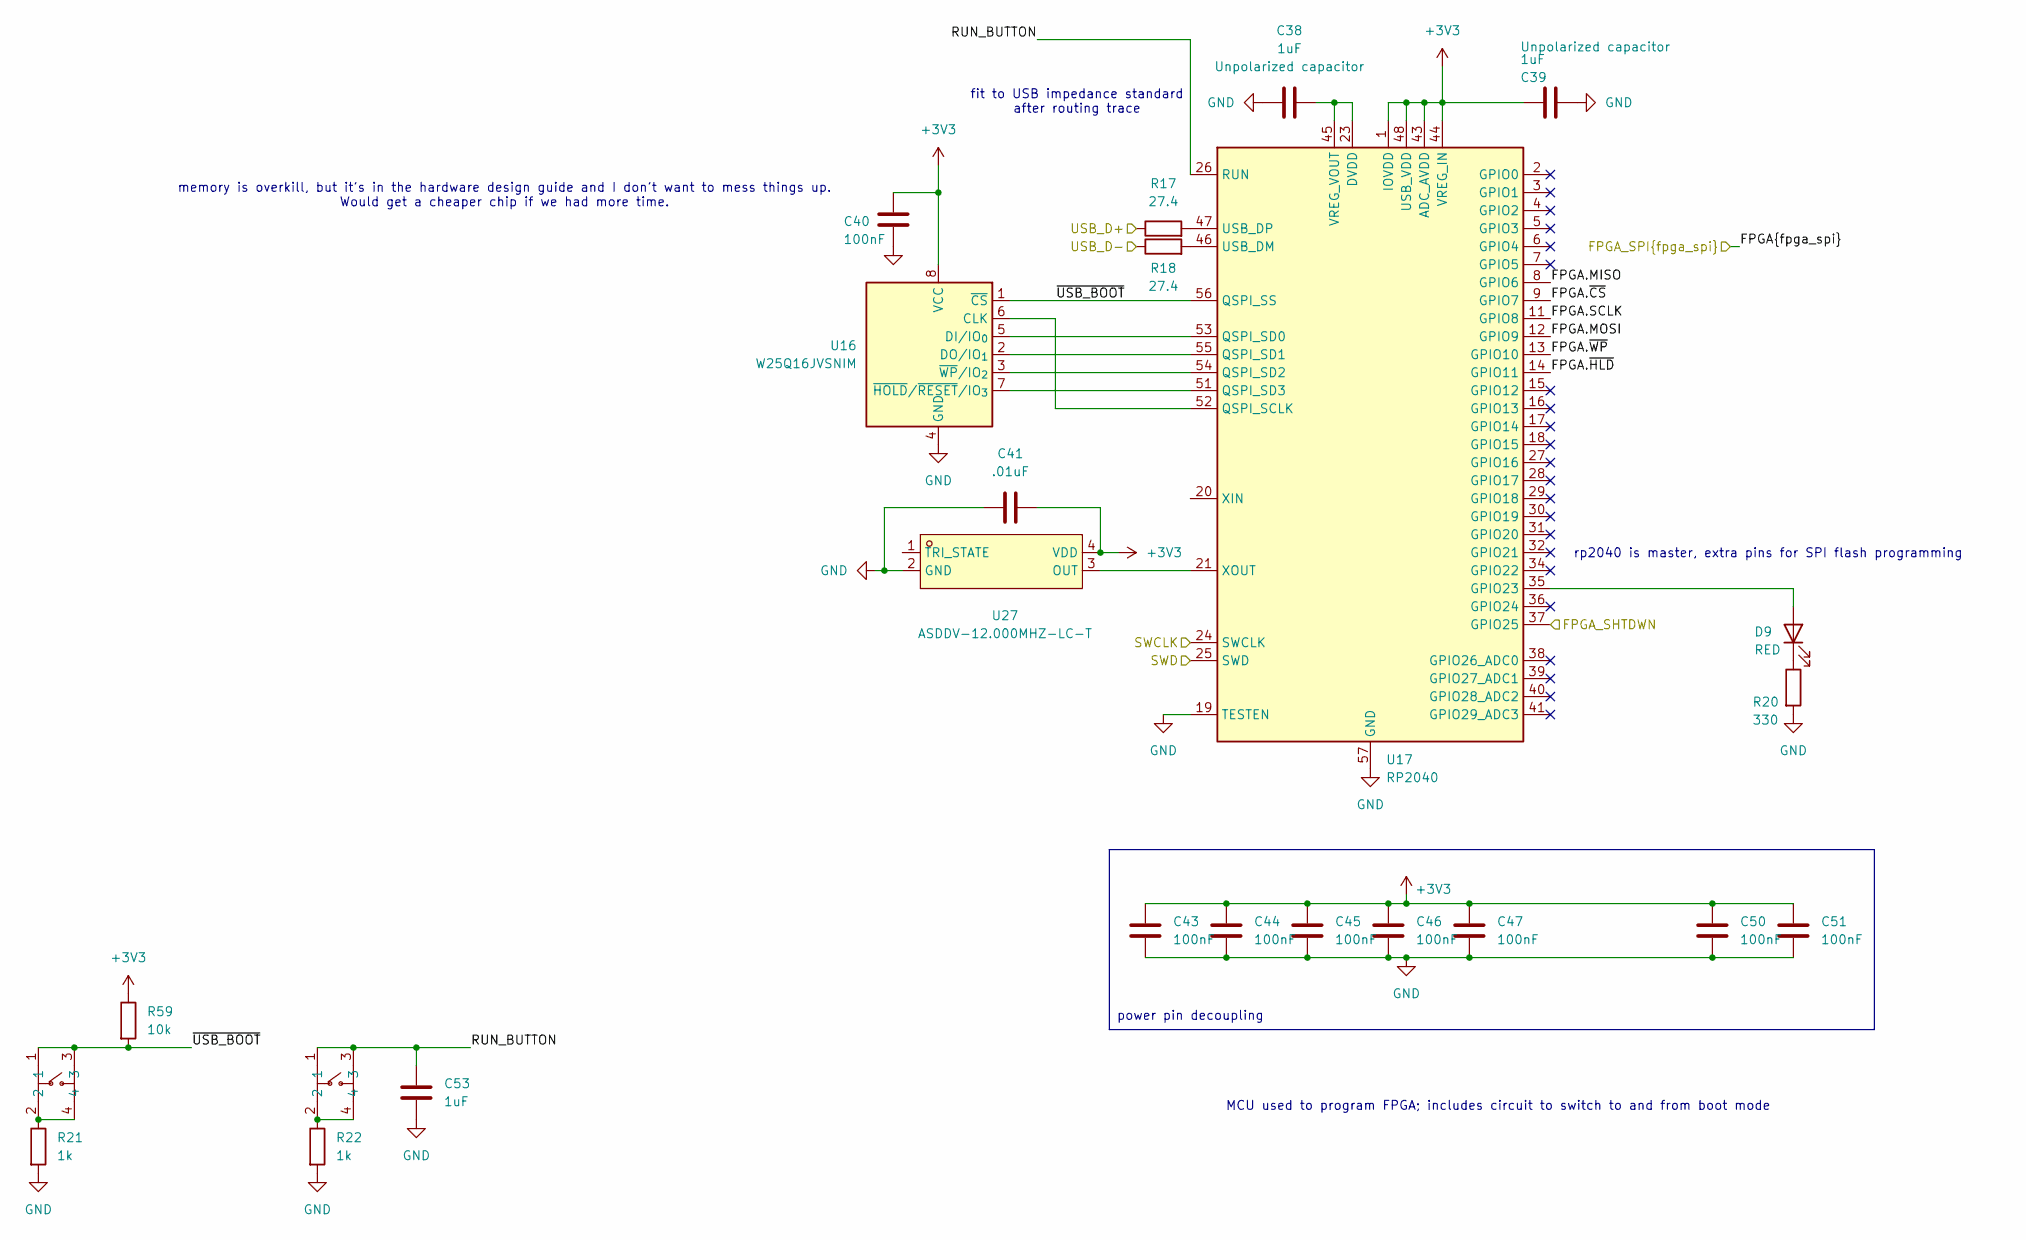
[picture p9: schematic mcu.kicad_sch]

Parts:
C38, C39, C53: 1uF; C_0603_1608Metric; Mouser # 791-0201X105M6R3CT
C40, C43, C44, C45, C46, C47, C50, C51: 100nF; C_0603_1608Metric; Mouser # KGM15AR71C104MM
C41: .01uF; C_0603_1608Metric; Mouser # 603-CC603ZRY5V8BB103
D9: RED; LED_0603_1608Metric; Mouser # 720-LSQ976.01-N1Q2-1
R17, R18: 27.4; R_0603_1608Metric; Mouser # 603-RC0603FR-0727R4L
R20: 330; R_0603_1608Metric; Mouser # 603-RC0603FR-10330RL
R21, R22: 1k; R_0603_1608Metric; Mouser # 660-RK73H1JTTDD1001F
R59: 10k; R_0603_1608Metric; Mouser # 652-CRT0603BY1002ELF
U16: W25Q16JVSNIM; SOIC-8_5.3x5.3mm_P1.27mm; Mouser # 454-W25Q16JVSNIM
U17: RP2040; QFN-56-1EP_7x7mm_P0.4mm_EP3.2x3.2mm; Mouser # 358-SC091413
U27: ASDDV-12.000MHZ-LC-T; OSC-SMD_4P-L2.5-W2.0-BL_ABRACON_ASTMLPD; Mouser # 815-ASDDV-1200MHZLCT; LCSC Part C1857773
b_up1, b_up2: TSD003A04126A02; SW-SMD_4P-L6.0-W6.0-P4.50-LS8.6; Mouser # NA; LCSC Part C2888573

Connections:
+3V3: C39.1, C40.1, C41.2, C43.1, C44.1, C45.1, C46.1, C47.1, C50.1, C51.1, R59.1, U16.8 (VCC), U17.1 (IOVDD), U17.10 (IOVDD), U17.22 (IOVDD), U17.33 (IOVDD), U17.42 (IOVDD), U17.43 (ADC_AVDD), U17.44 (VREG_IN), U17.48 (USB_VDD), U17.49 (IOVDD), U27.4 (VDD); also elsewhere on the board
/CV inputs/FPGA_SHTDWN: U17.37 (GPIO25); also elsewhere on the board
/FPGA/SPI_MASTER.MISO: U17.8 (GPIO6); also elsewhere on the board
/FPGA/SPI_MASTER.MOSI: U17.12 (GPIO9); also elsewhere on the board
/FPGA/SPI_MASTER.SCLK: U17.11 (GPIO8); also elsewhere on the board
/FPGA/SPI_MASTER.~CS: U17.9 (GPIO7); also elsewhere on the board
/FPGA/SPI_MASTER.~HLD: U17.14 (GPIO11); also elsewhere on the board
/FPGA/SPI_MASTER.~WP: U17.13 (GPIO10); also elsewhere on the board
/USB_D+: R17.1; also elsewhere on the board
/USB_D-: R18.1; also elsewhere on the board
/mcu/RUN_BUTTON: C53.1, U17.26 (RUN), b_up2.1, b_up2.3
/mcu/SWCLK: U17.24 (SWCLK); also elsewhere on the board
/mcu/SWD: U17.25 (SWD); also elsewhere on the board
/mcu/~USB_BOOT: R59.2, U16.1 (~CS), U17.56 (QSPI_SS), b_up1.1, b_up1.3
GND: C38.2, C39.2, C40.2, C41.1, C43.2, C44.2, C45.2, C46.2, C47.2, C50.2, C51.2, C53.2, R20.2, R21.2, R22.2, U16.4 (GND), U17.19 (TESTEN), U17.57 (GND), U27.2 (GND); also elsewhere on the board
unnamed: D9.2 (A), U17.35 (GPIO23)
unnamed: D9.1 (K), R20.1
unnamed: R21.1, b_up1.2, b_up1.4
unnamed: R22.1, b_up2.2, b_up2.4
unnamed: U16.6 (CLK), U17.52 (QSPI_SCLK)
unnamed: U16.5 (DI/IO_{0}), U17.53 (QSPI_SD0)
unnamed: U16.2 (DO/IO_{1}), U17.55 (QSPI_SD1)
unnamed: U16.7 (~HOLD/~RESET/IO_{3}), U17.51 (QSPI_SD3)
unnamed: U16.3 (~WP/IO_{2}), U17.54 (QSPI_SD2)
unnamed: R18.2, U17.46 (USB_DM)
unnamed: R17.2, U17.47 (USB_DP)
unnamed: C38.1, U17.23 (DVDD), U17.45 (VREG_VOUT), U17.50 (DVDD)
unnamed: U17.21 (XOUT), U27.3 (OUT)

Notes on the sheet:
power pin decoupling
MCU used to program FPGA; includes circuit to switch to and from boot mode
rp2040 is master, extra pins for SPI flash programming
fit to USB impedance standard after routing trace
memory is overkill, but it's in the hardware design guide and I don't want to mess things up. Would get a cheaper chip if we had more time.

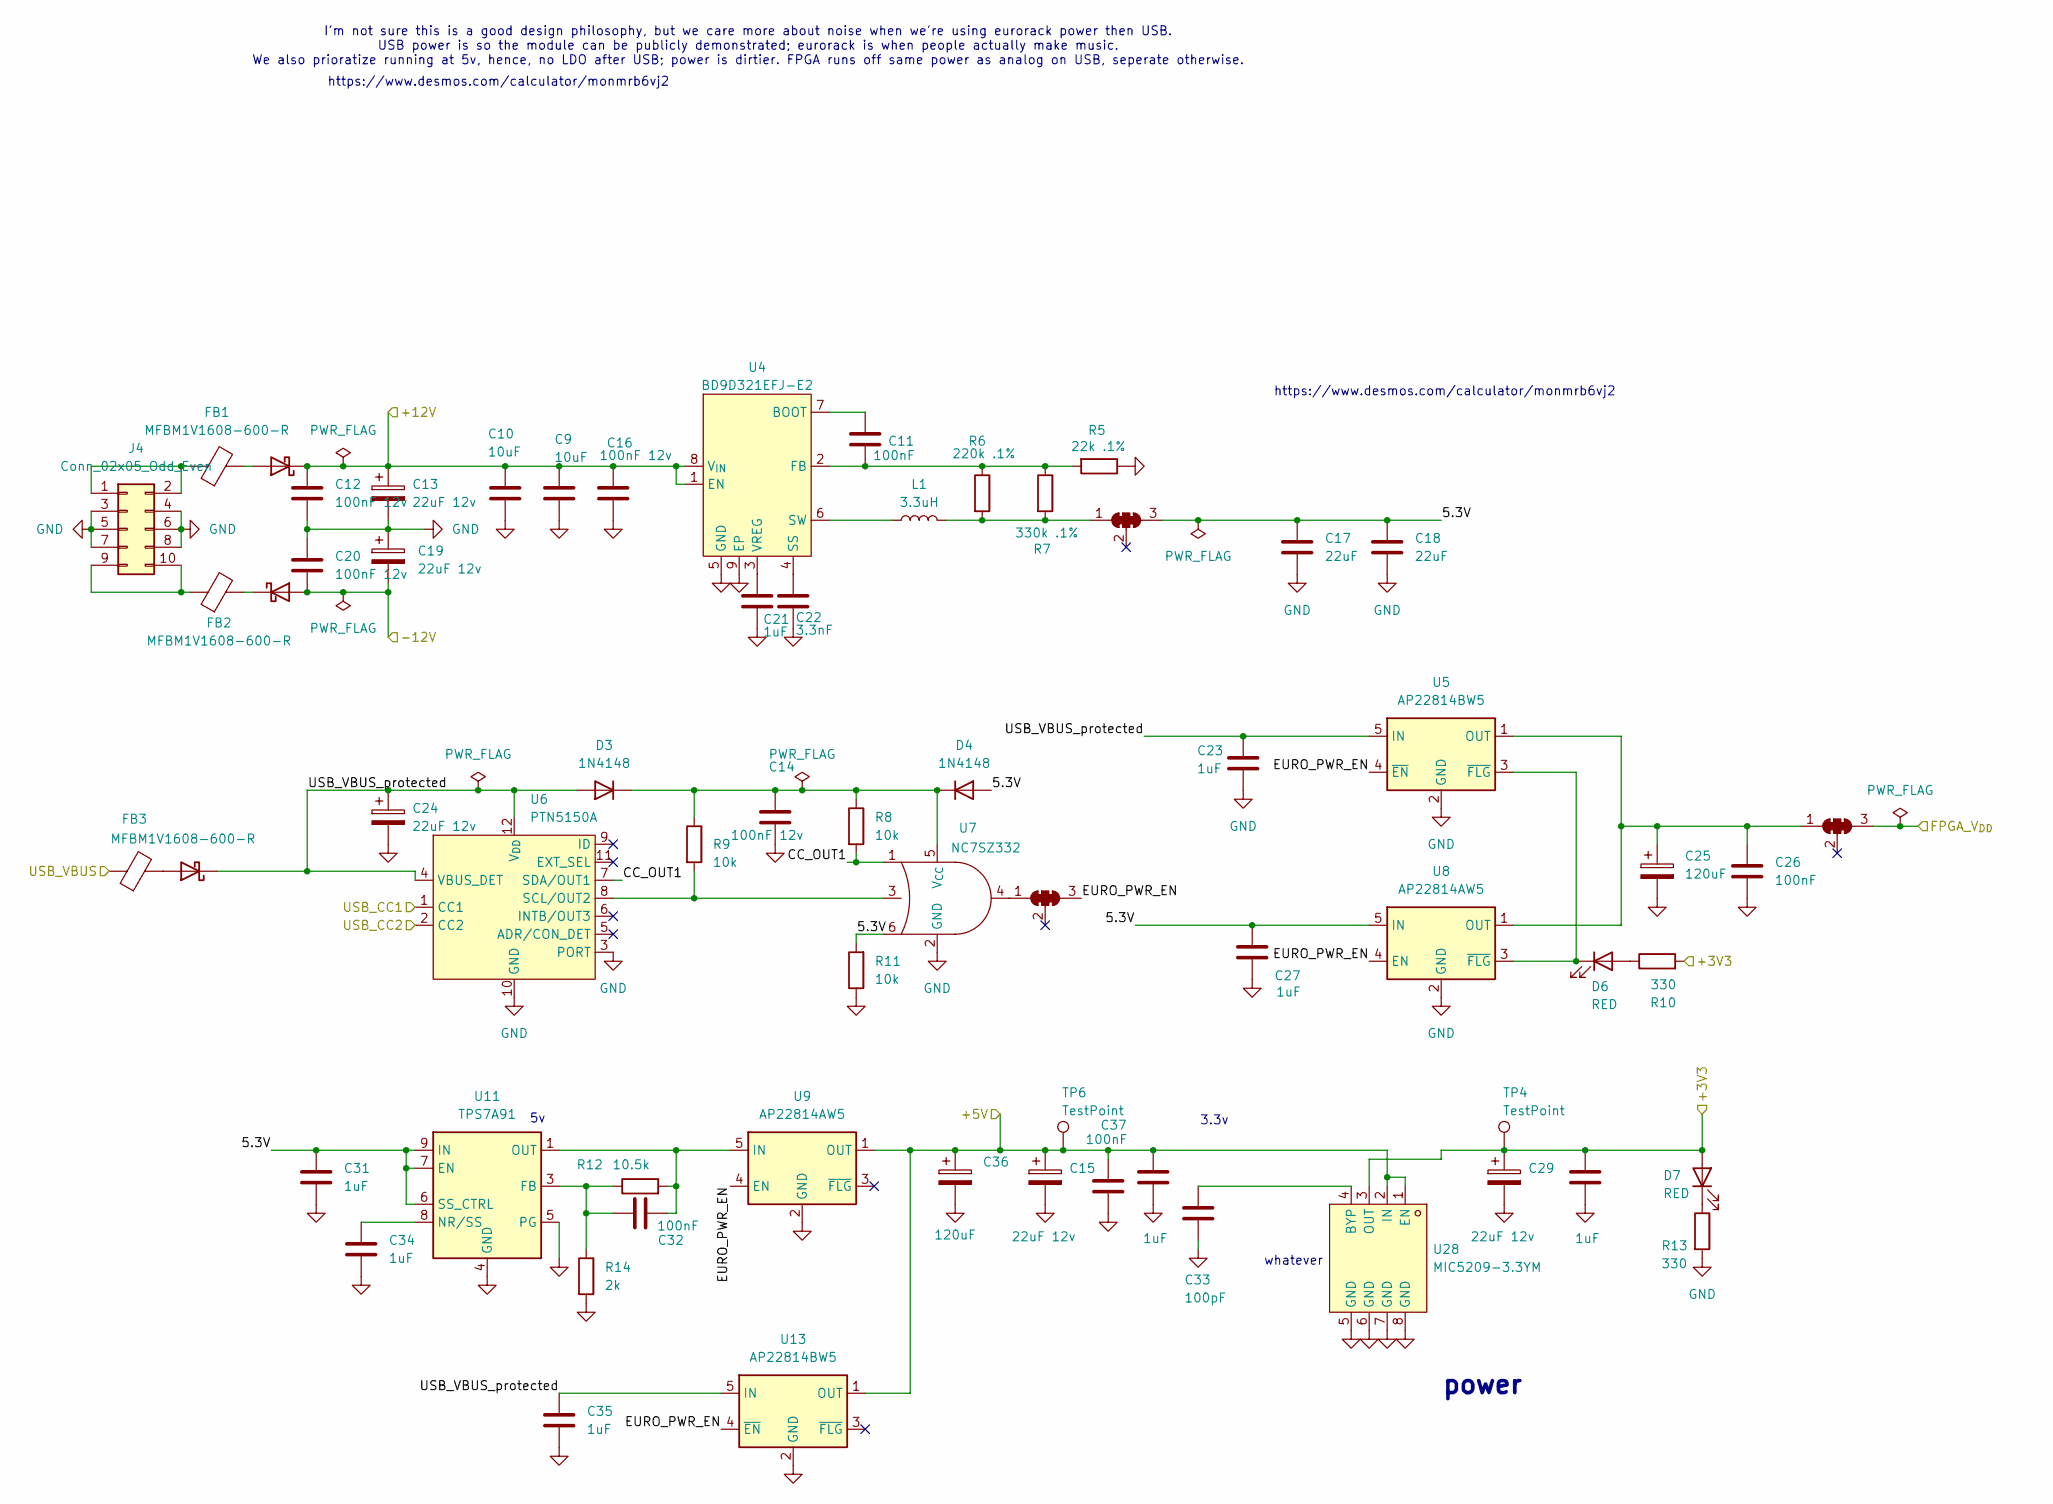
[picture p10: schematic power.kicad_sch]

Parts:
C9, C10: 10uF; CP_EIA-3216-18_Kemet-A; Mouser # 581-TAJA106K016R
C11, C26, C32, C37: 100nF; C_0603_1608Metric; Mouser # KGM15AR71C104MM
C12, C14, C16, C20: 100nF 12v; C_0603_1608Metric; Mouser # KGM15AR71C104MM
C13, C15, C19, C24, C29: 22uF 12v; CP_EIA-3528-21_Kemet-B; Mouser # 581-TAJB226K016TNJ
C17, C18: 22uF; C_0603_1608Metric; Mouser # 81-GRM188R60J226ME5J
C21, C23, C27, C28, C30, C31, C34, C35: 1uF; C_0603_1608Metric; Mouser # 791-0201X105M6R3CT
C22: 3.3nF; C_0603_1608Metric; Mouser # CL10B332KB8NFNC
C25, C36: 120uF; CP_EIA-3528-21_Kemet-B; Mouser # 581-TPSB107M006R0400
C33: 100pF; C_0603_1608Metric; Mouser # 603-CC603KRX7R8BB101
D1: SK34SMA-3G; D_SMA; Mouser # 637-SK34SMA-3G
D2, D5: SK34SMA-3G; D_SMA; mfr # SK34SMA-3G; Mouser # 637-SK34SMA-3G
D3, D4: 1N4148; D_SOD-323F; Mouser # 637-1N4148WS-AQ
D6, D7: RED; LED_0603_1608Metric; Mouser # 720-LSQ976.01-N1Q2-1
FB1, FB2, FB3: MFBM1V1608-600-R; L_0603_1608Metric; Mouser # 704-MFBM1V1608-600-R
J4: Conn_02x05_Odd_Even; IDC-Header_2x05_P2.54mm_Vertical; Mouser # 737-BHR-10-VUA
JP1, JP2, JP3: SolderJumper_3_Bridged123; SolderJumper-3_P2.0mm_Open_TrianglePad1.0x1.5mm
L1: 3.3uH; L_APV_ANR4012; Mouser # 963-NRS4012T3R3MDGJ
R5: 22k .1%; R_0603_1608Metric; Mouser # 754-RG1608P-223-B-T5
R6: 220k .1%; R_0603_1608Metric; Mouser # 754-RG1608P-224-BT5
R7: 330k .1%; R_0603_1608Metric; Mouser # 754-RG1608P-334-B-T5
R8, R9, R11: 10k; R_0603_1608Metric; Mouser # 652-CRT0603BY1002ELF
R10, R13: 330; R_0603_1608Metric; Mouser # 603-RC0603FR-10330RL
R12: 10.5k; R_0603_1608Metric; Mouser # 667-ERA-3AEB1052V
R14: 2k; R_0603_1608Metric; Mouser # 660-RN73H1JTD2001B25
TP4, TP6: TestPoint; TestPoint_Pad_2.0x2.0mm; Mouser # NA
U4: BD9D321EFJ-E2; HTSOP-8-1EP_3.9x4.9mm_P1.27mm_EP2.4x3.2mm; Mouser # 755-BD9D321EFJ-E2
U5, U13: AP22814BW5; SOT-23-5; Mouser # 621-AP22814BW5-7
U6: PTN5150A; Texas_X2QFN-12_1.6x1.6mm_P0.4mm; Mouser # 771-PTN5150AHXMP
U7: NC7SZ332; SOT-363_SC-70-6; Mouser # 512-NC7SZ332P6X
U8, U9: AP22814AW5; SOT-23-5; Mouser # 621-AP22814AW5-7
U11: TPS7A91; SON50P250X250X80-11N-D; Mouser # 595-TPS7A9101DSKR
U28: MIC5209-3.3YM; SOIC-8_L4.9-W3.9-P1.27-LS6.0-BL; Mouser # MIC5209-3.3YM

Connections:
+3V3: C29.1, C30.1, D7.2 (A), R10.2, TP4.1, U28.3 (OUT); also elsewhere on the board
+5V: C15.1, C28.1, C36.1, C37.1, TP6.1, U9.1 (OUT), U13.1 (OUT), U28.1 (EN), U28.2 (IN); also elsewhere on the board
+12V: C9.1, C10.1, C12.2, C13.1, C16.1, D1.1 (K), U4.1 (EN), U4.8 (V_{IN}); also elsewhere on the board
-12V: C19.2, C20.1, D2.2 (A); also elsewhere on the board
/FPGA/FPGA_VDD: JP2.3 (B); also elsewhere on the board
/USB_CC1: U6.1 (CC1); also elsewhere on the board
/USB_CC2: U6.2 (CC2); also elsewhere on the board
/USB_VBUS: FB3.1; also elsewhere on the board
/power/5.3V: C17.1, C18.1, C27.1, C31.1, D4.2 (A), JP1.3 (B), R11.2, U7.6, U8.5 (IN), U11.6 (SS_CTRL), U11.7 (EN), U11.9 (IN), U11.10 (IN)
/power/CC_OUT1: R8.2, U6.7 (SDA/OUT1), U7.1
/power/EURO_PWR_EN: JP3.3 (B), U5.4 (~EN), U8.4 (EN), U9.4 (EN), U13.4 (~EN)
/power/USB_VBUS_protected: C23.1, C24.1, C35.1, D3.2 (A), D5.1 (K), U5.5 (IN), U6.4 (VBUS_DET), U6.12 (V_{DD}), U13.5 (IN)
GND: C9.2, C10.2, C12.1, C13.2, C14.2, C15.2, C16.2, C17.2, C18.2, C19.1, C20.2, C21.2, C22.2, C23.2, C24.2, C25.2, C26.2, C27.2, C28.2, C29.2, C30.2, C31.2, C33.2, C34.2, C35.2, C36.2, C37.2, J4.3, J4.4, J4.5, J4.6, J4.7, J4.8, R5.1, R11.1, R13.2, R14.2, U4.5 (GND), U4.9 (EP), U5.2 (GND), U6.3 (PORT), U6.10 (GND), U7.2 (GND), U8.2 (GND), U9.2 (GND), U11.4 (GND), U11.5 (PG), U11.11 (GND), U13.2 (GND), U28.5 (GND), U28.6 (GND), U28.7 (GND), U28.8 (GND); also elsewhere on the board
unnamed: D1.2 (A), FB1.2
unnamed: D2.1 (K), FB2.2
unnamed: C14.1, D3.1 (K), D4.1 (K), R8.1, R9.1, U7.5 (V_{CC})
unnamed: D5.2 (A), FB3.2
unnamed: D6.2 (A), R10.1
unnamed: D6.1 (K), U5.3 (~FLG), U8.3 (~FLG)
unnamed: D7.1 (K), R13.1
unnamed: FB1.1, J4.1, J4.2
unnamed: FB2.1, J4.9, J4.10
unnamed: JP1.1 (A), L1.2, R6.2, R7.2
unnamed: C25.1, C26.1, JP2.1 (A), U5.1 (OUT), U8.1 (OUT)
unnamed: JP3.1 (A), U7.4
unnamed: C11.2, U4.7 (BOOT)
unnamed: C11.1, R5.2, R6.1, R7.1, U4.2 (FB)
unnamed: C22.1, U4.4 (SS)
unnamed: L1.1, U4.6 (SW)
unnamed: C21.1, U4.3 (VREG)
unnamed: R9.2, U6.8 (SCL/OUT2), U7.3
unnamed: C32.1, R12.2, U9.5 (IN), U11.1 (OUT), U11.2 (OUT)
unnamed: C32.2, R12.1, R14.1, U11.3 (FB)
unnamed: C34.1, U11.8 (NR/SS)
unnamed: C33.1, U28.4 (BYP)

Notes on the sheet:
3.3v
power
whatever
https://www.desmos.com/calculator/monmrb6vj2
I'm not sure this is a good design philosophy, but we care more about noise when we're using eurorack power then USB. USB power is so the module can be publicly demonstrated; eurorack is when people actually make music. We also prioratize running at 5v, hence, no LDO after USB; power is dirtier. FP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

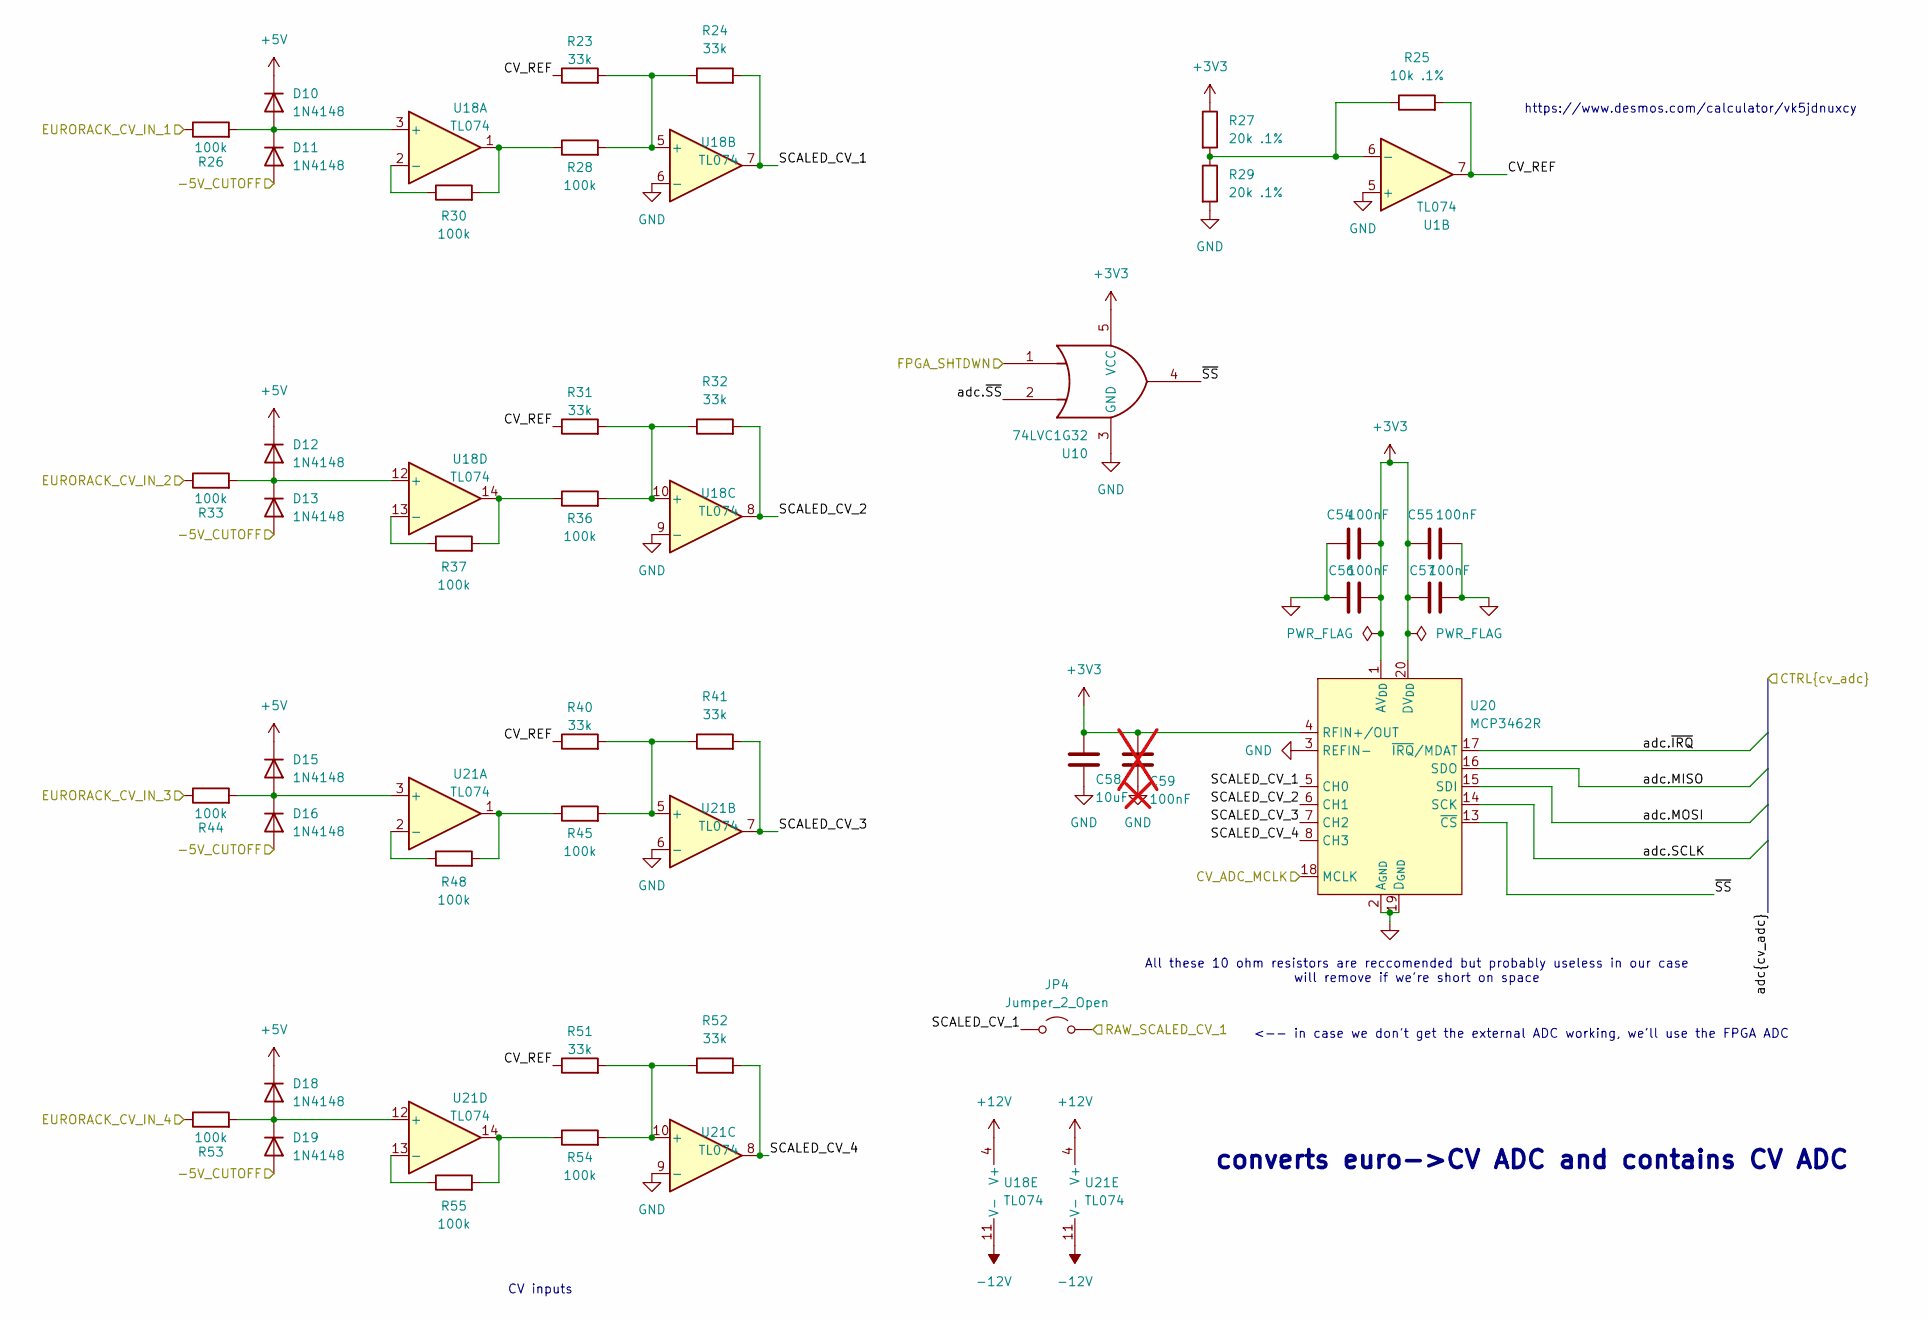
[picture p11: schematic CV inputs.kicad_sch]

Parts:
C54, C55, C56, C57: 100nF; C_0603_1608Metric; Mouser # KGM15AR71C104MM
C58: 10uF; CP_EIA-3216-18_Kemet-A; Mouser # 581-TAJA106K016R
C59: 100nF; C_0603_1608Metric; Mouser # KGM15AR71C104MM; not fitted
D10, D11, D12, D13, D15, D16, D18, D19: 1N4148; D_SOD-323F; Mouser # 637-1N4148WS-AQ
JP4: Jumper_2_Open; R_0603_1608Metric
R23, R24, R31, R32, R40, R41, R51, R52: 33k; R_0603_1608Metric; Mouser # CR0603-FX-3302ELF
R25: 10k .1%; R_0603_1608Metric; Mouser # 652-CRT0603BY1002ELF
R26, R28, R30, R33, R36, R37, R44, R45, R48, R53, R54, R55: 100k; R_0603_1608Metric; Mouser # CR0603-FX-1003ELF
R27, R29: 20k .1%; R_0603_1608Metric; Mouser # 708-RNCF0603BTC20K0
U1, U18, U21: TL074; TSSOP-14_4.4x5mm_P0.65mm; Mouser # 595-TL074HIPWR
U10: 74LVC1G32; SOT-353_SC-70-5; Mouser # 771-74LVC1G32GW-G
U20: MCP3462R; TSSOP-20_4.4x6.5mm_P0.65mm; Mouser # MCP3462R-E/ST

Connections:
+3V3: C54.2, C55.1, C56.2, C57.1, C58.1, C59.1, R27.1, U10.5 (VCC), U20.1 (AV_{DD}), U20.4 (RFIN+/OUT), U20.20 (DV_{DD}); also elsewhere on the board
+5V: D10.1 (K), D12.1 (K), D15.1 (K), D18.1 (K); also elsewhere on the board
+12V: U18.4 (V+), U21.4 (V+); also elsewhere on the board
-12V: U18.11 (V-), U21.11 (V-); also elsewhere on the board
/-5V_CUTOFF: D11.2 (A), D13.2 (A), D16.2 (A), D19.2 (A); also elsewhere on the board
/CV inputs/CV_ADC_MCLK: U20.18 (MCLK); also elsewhere on the board
/CV inputs/CV_REF: R23.1, R25.2, R31.1, R40.1, R51.1, U1.7
/CV inputs/FPGA_SHTDWN: U10.1; also elsewhere on the board
/CV inputs/RAW_SCALED_CV_1: JP4.2 (B); also elsewhere on the board
/CV inputs/SCALED_CV_1: JP4.1 (A), R24.2, U18.7, U20.5 (CH0)
/CV inputs/SCALED_CV_2: R32.2, U18.8, U20.6 (CH1)
/CV inputs/SCALED_CV_3: R41.2, U20.7 (CH2), U21.7
/CV inputs/SCALED_CV_4: R52.2, U20.8 (CH3), U21.8
/CV inputs/adc.MISO: U20.16 (SDO)
/CV inputs/adc.MOSI: U20.15 (SDI); also elsewhere on the board
/CV inputs/adc.SCLK: U20.14 (SCK); also elsewhere on the board
/CV inputs/adc.~IRQ: U20.17 (~IRQ/MDAT)
/CV inputs/adc.~SS: U10.2; also elsewhere on the board
/CV inputs/~SS: U10.4, U20.13 (~CS)
/EURORACK_CV_IN_1: R26.1; also elsewhere on the board
/EURORACK_CV_IN_2: R33.1; also elsewhere on the board
/EURORACK_CV_IN_3: R44.1; also elsewhere on the board
/EURORACK_CV_IN_4: R53.1; also elsewhere on the board
GND: C54.1, C55.2, C56.1, C57.2, C58.2, C59.2, R29.2, U1.5 (+), U10.3 (GND), U18.6 (-), U18.9 (-), U20.2 (A_{GND}), U20.3 (REFIN-), U20.19 (D_{GND}), U21.6 (-), U21.9 (-); also elsewhere on the board
unnamed: D10.2 (A), D11.1 (K), R26.2, U18.3 (+)
unnamed: D12.2 (A), D13.1 (K), R33.2, U18.12 (+)
unnamed: D15.2 (A), D16.1 (K), R44.2, U21.3 (+)
unnamed: D18.2 (A), D19.1 (K), R53.2, U21.12 (+)
unnamed: R28.1, R30.2, U18.1
unnamed: R36.1, R37.2, U18.14
unnamed: R45.1, R48.2, U21.1
unnamed: R54.1, R55.2, U21.14
unnamed: R25.1, R27.2, R29.1, U1.6 (-)
unnamed: R30.1, U18.2 (-)
unnamed: R23.2, R24.1, R28.2, U18.5 (+)
unnamed: R31.2, R32.1, R36.2, U18.10 (+)
unnamed: R37.1, U18.13 (-)
unnamed: R48.1, U21.2 (-)
unnamed: R40.2, R41.1, R45.2, U21.5 (+)
unnamed: R51.2, R52.1, R54.2, U21.10 (+)
unnamed: R55.1, U21.13 (-)

Notes on the sheet:
converts euro->CV ADC and contains CV ADC
<-- in case we don't get the external ADC working, we'll use the FPGA ADC
All these 10 ohm resistors are reccomended but probably useless in our case will remove if we're short on space
https://www.desmos.com/calculator/vk5jdnuxcy
CV inputs

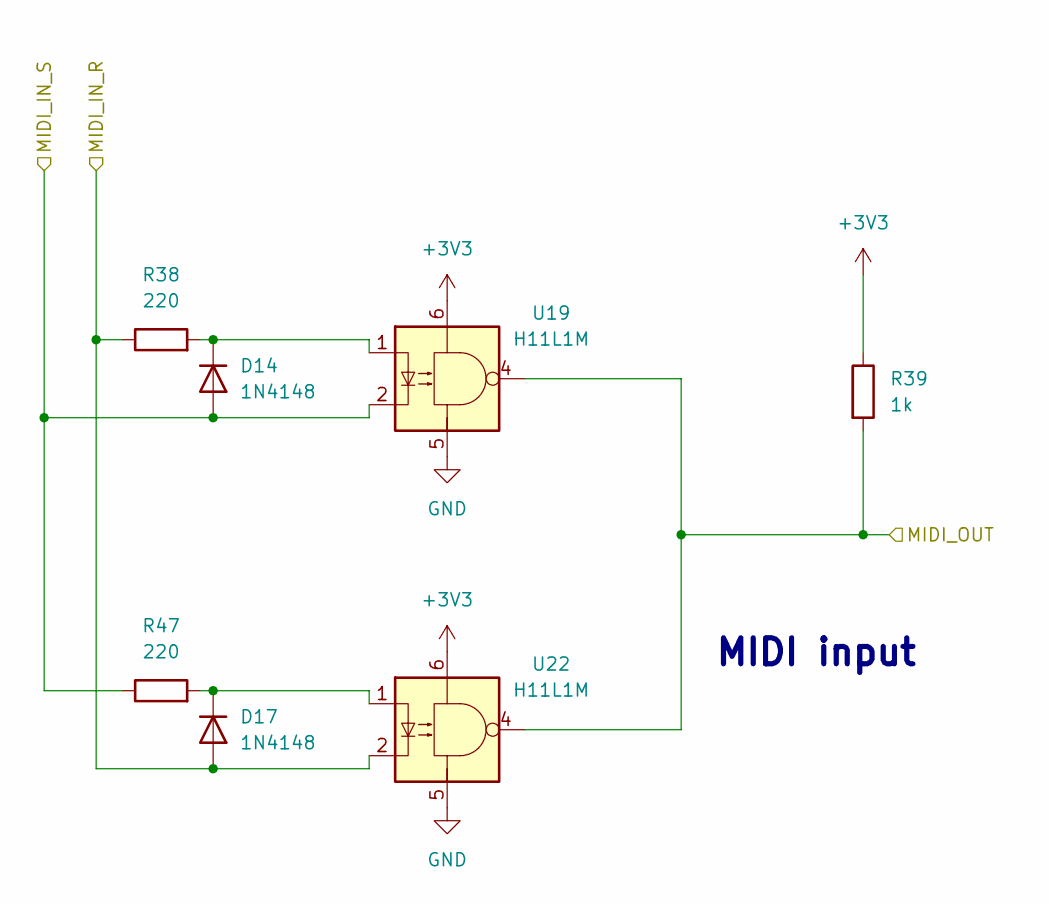
[picture p12: schematic midi.kicad_sch]

Parts:
D14, D17: 1N4148; D_SOD-323F; Mouser # 637-1N4148WS-AQ
R38, R47: 220; R_0603_1608Metric; Mouser # 652-CR0603FX-2200ELF
R39: 1k; R_0603_1608Metric; Mouser # 660-RK73H1JTTDD1001F
U19, U22: H11L1M; DIP-6_W7.62mm; Mouser # 512-H11L1M

Connections:
+3V3: R39.1, U19.6, U22.6; also elsewhere on the board
/FPGA/MIDI_IN: R39.2, U19.4, U22.4; also elsewhere on the board
/MIDI_IN_R: D17.2 (A), R38.1, U22.2; also elsewhere on the board
/MIDI_IN_S: D14.2 (A), R47.1, U19.2; also elsewhere on the board
GND: U19.5, U22.5; also elsewhere on the board
unnamed: D14.1 (K), R38.2, U19.1
unnamed: D17.1 (K), R47.2, U22.1

Notes on the sheet:
MIDI input

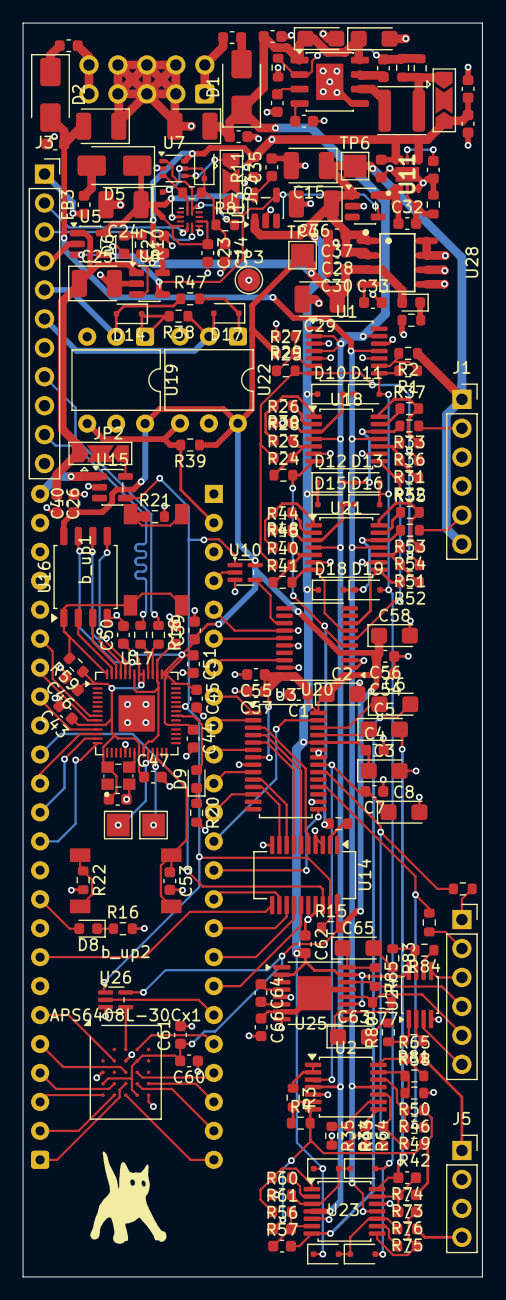
[picture p13: board fieldbox.kicad_pcb from above]

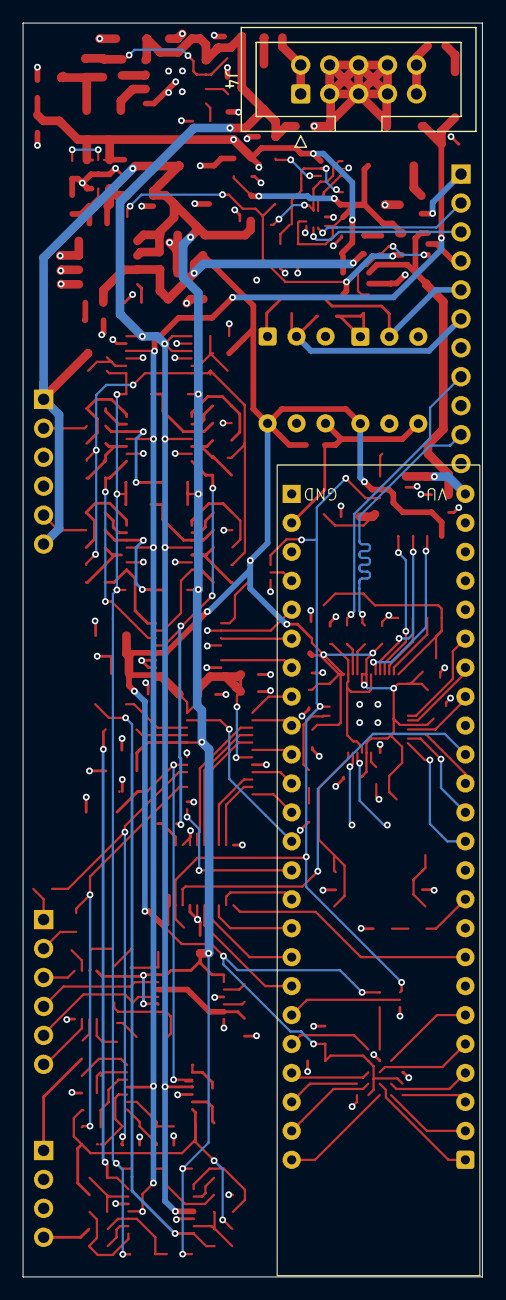
[picture p14: board fieldbox.kicad_pcb from below]

Board: 4 copper layers, 40.3 x 110.0 mm, 209 parts (2 on the bottom side), 179 nets.
