awesomebrick/fieldbox/hardware/controls_pcb/fieldbox_controls/fieldbox_controls.kicad_pcb

## KiCad design hardware/controls_pcb/fieldbox_controls/fieldbox_controls.kicad_pcb (2026-04-05)

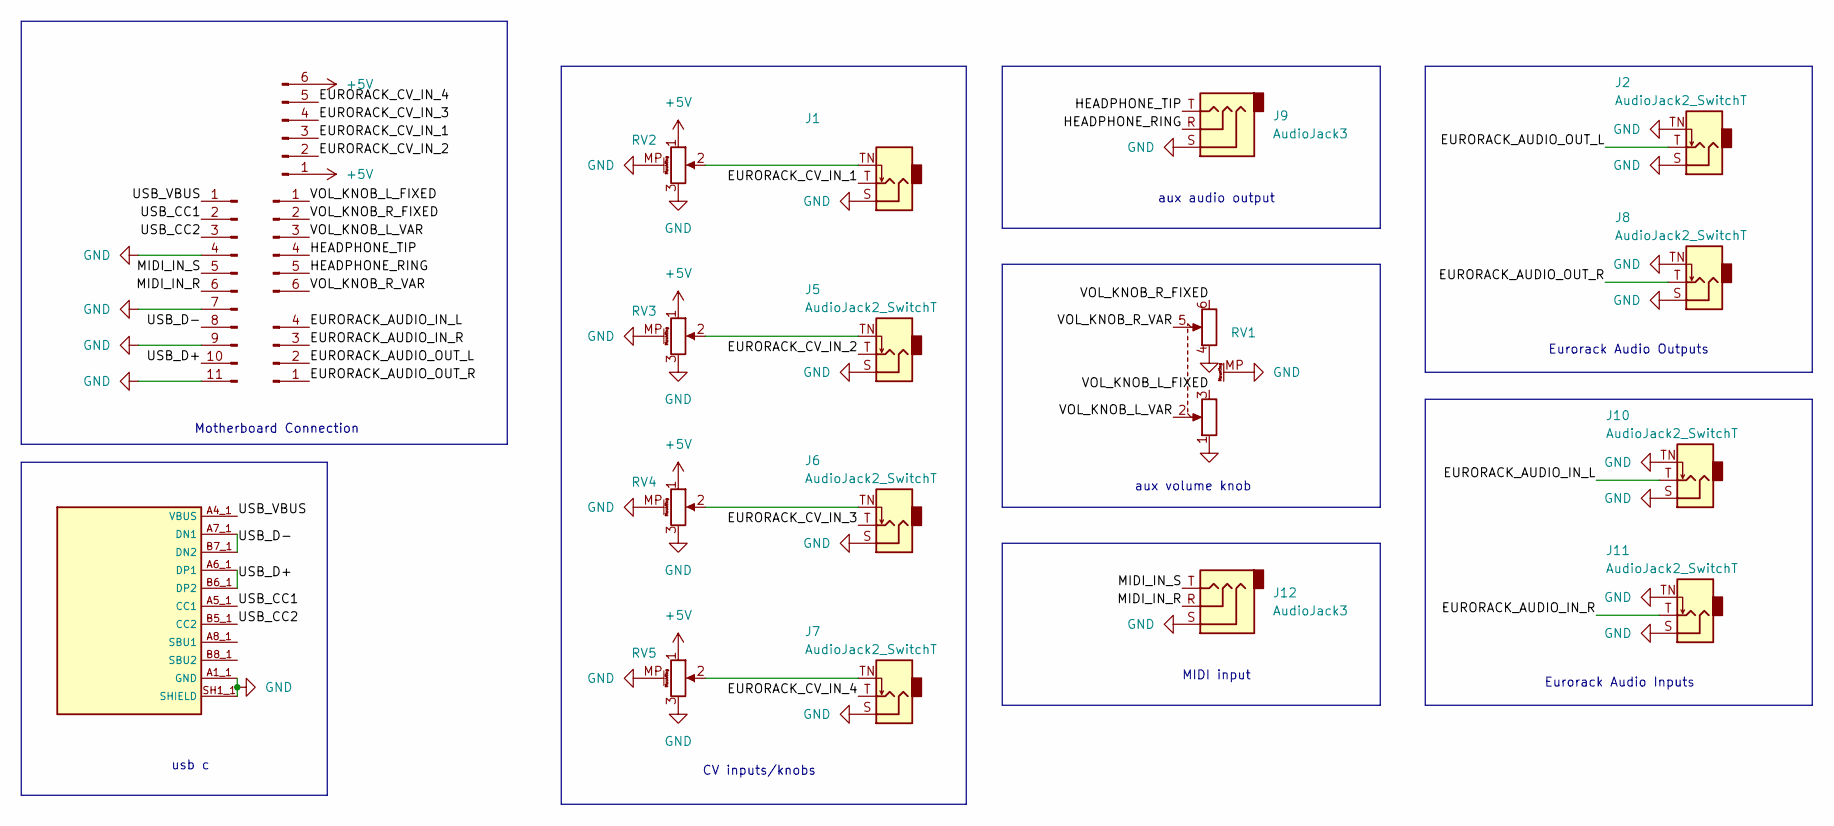
[picture p15: schematic fieldbox_controls.kicad_sch]

Parts:
J1, J2, J5, J6, J7, J8, J10, J11: AudioJack2_SwitchT; Jack_3.5mm_QingPu_WQP-PJ398SM_Vertical
J9, J12: AudioJack3; Jack_3.5mm_QingPu_WQP-PJ366ST_Vertical
J13: Conn_01x06_Socket; PinHeader_1x06_P2.54mm_Vertical
J14: Conn_01x04_Socket; PinHeader_1x06_P2.54mm_Vertical
J15: Conn_01x11_Socket; PinHeader_1x11_P2.54mm_Vertical
J16: Conn_01x04_Socket; PinHeader_1x04_P2.54mm_Vertical
RV1: R_Potentiometer_Dual_MountingPin; RK09L12D0A1W; Mouser # 688-RK09L12D0A1W
RV2, RV3, RV4, RV5: R_Potentiometer_MountingPin; RK09L114001E; Mouser # 688-RK09L114001T
U1: CUI_UJ20-C-V-C-3-SMT-TR; Mouser # 179-UJ20CVC3SMTTR

Connections:
+5V: J14.1, J14.6, RV2.1, RV3.1, RV4.1, RV5.1
/EURORACK_AUDIO_IN_L: J10.T, J16.4
/EURORACK_AUDIO_IN_R: J11.T, J16.3
/EURORACK_AUDIO_OUT_L: J2.T, J16.2
/EURORACK_AUDIO_OUT_R: J8.T, J16.1
/EURORACK_CV_IN_1: J1.T, J14.3
/EURORACK_CV_IN_2: J5.T, J14.2
/EURORACK_CV_IN_3: J6.T, J14.4
/EURORACK_CV_IN_4: J7.T, J14.5
/HEADPHONE_RING: J9.R, J13.5
/HEADPHONE_TIP: J9.T, J13.4
/MIDI_IN_R: J12.R, J15.6
/MIDI_IN_S: J12.T, J15.5
/USB_CC1: J15.2, U1.A5_1 (CC1), U1.A5_2 (CC1__1), U1.A5_3 (CC1__2), U1.A5_4 (CC1__3)
/USB_CC2: J15.3, U1.B5_1 (CC2), U1.B5_2 (CC2__1), U1.B5_3 (CC2__2), U1.B5_4 (CC2__3)
/USB_D+: J15.10, U1.A6_1 (DP1), U1.A6_2 (DP1__1), U1.A6_3 (DP1__2), U1.A6_4 (DP1__3), U1.B6_1 (DP2), U1.B6_2 (DP2__1), U1.B6_3 (DP2__2), U1.B6_4 (DP2__3)
/USB_D-: J15.8, U1.A7_1 (DN1), U1.A7_2 (DN1__1), U1.A7_3 (DN1__2), U1.A7_4 (DN1__3), U1.B7_1 (DN2), U1.B7_2 (DN2__1), U1.B7_3 (DN2__2), U1.B7_4 (DN2__3)
/USB_VBUS: J15.1, U1.A4_1 (VBUS), U1.A4_2 (VBUS__1), U1.A4_3 (VBUS__2), U1.A4_4 (VBUS__3), U1.A9_1 (VBUS__4), U1.A9_2 (VBUS__5), U1.A9_3 (VBUS__6), U1.A9_4 (VBUS__7), U1.B4_1 (VBUS__8), U1.B4_2 (VBUS__9), U1.B4_3 (VBUS__10), U1.B4_4 (VBUS__11), U1.B9_1 (VBUS__12), U1.B9_2 (VBUS__13), U1.B9_3 (VBUS__14), U1.B9_4 (VBUS__15)
/VOL_KNOB_L_FIXED: J13.1, RV1.3
/VOL_KNOB_L_VAR: J13.3, RV1.2
/VOL_KNOB_R_FIXED: J13.2, RV1.6
/VOL_KNOB_R_VAR: J13.6, RV1.5
GND: J1.S, J2.S, J2.TN, J5.S, J6.S, J7.S, J8.S, J8.TN, J9.S, J10.S, J10.TN, J11.S, J11.TN, J12.S, J15.4, J15.7, J15.9, J15.11, RV1.1, RV1.4, RV1.MP (MountPin), RV2.3, RV2.MP (MountPin), RV3.3, RV3.MP (MountPin), RV4.3, RV4.MP (MountPin), RV5.3, RV5.MP (MountPin), U1.A1_1 (GND), U1.A1_2 (GND__1), U1.A1_3 (GND__2), U1.A1_4 (GND__3), U1.A12_1 (GND__4), U1.A12_2 (GND__5), U1.A12_3 (GND__6), U1.A12_4 (GND__7), U1.B1_1 (GND__8), U1.B1_2 (GND__9), U1.B1_3 (GND__10), U1.B1_4 (GND__11), U1.B12_1 (GND__12), U1.B12_2 (GND__13), U1.B12_3 (GND__14), U1.B12_4 (GND__15), U1.SH1_1 (SHIELD), U1.SH1_2 (SHIELD__1), U1.SH1_3 (SHIELD__2), U1.SH1_4 (SHIELD__3), U1.SH2_1 (SHIELD__4), U1.SH2_2 (SHIELD__5), U1.SH2_3 (SHIELD__6), U1.SH2_4 (SHIELD__7), U1.SH3_1 (SHIELD__8), U1.SH3_2 (SHIELD__9), U1.SH3_3 (SHIELD__10), U1.SH3_4 (SHIELD__11), U1.SH4_1 (SHIELD__12), U1.SH4_2 (SHIELD__13), U1.SH4_3 (SHIELD__14), U1.SH4_4 (SHIELD__15)
unnamed: J1.TN, RV2.2
unnamed: J5.TN, RV3.2
unnamed: J6.TN, RV4.2
unnamed: J7.TN, RV5.2
unnamed: U1.A8_1 (SBU1), U1.A8_2 (SBU1__1), U1.A8_3 (SBU1__2), U1.A8_4 (SBU1__3)
unnamed: U1.B8_1 (SBU2), U1.B8_2 (SBU2__1), U1.B8_3 (SBU2__2), U1.B8_4 (SBU2__3)

Notes on the sheet:
MIDI input
CV inputs/knobs
Eurorack Audio Outputs
Eurorack Audio Inputs
usb c
Motherboard Connection
aux audio output
aux volume knob

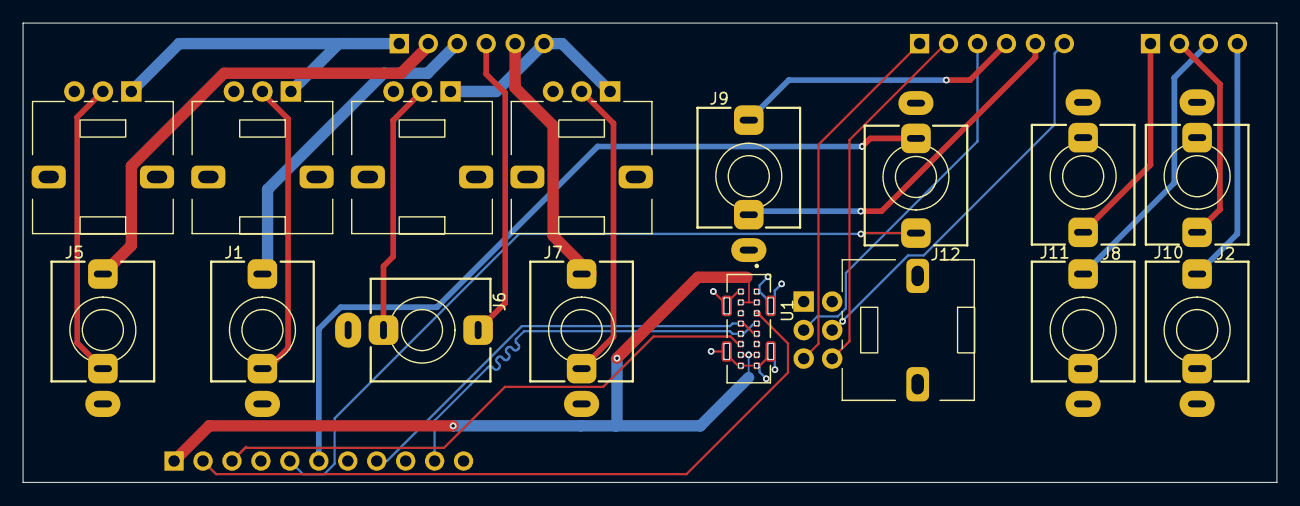
[picture p16: board fieldbox_controls.kicad_pcb from above]

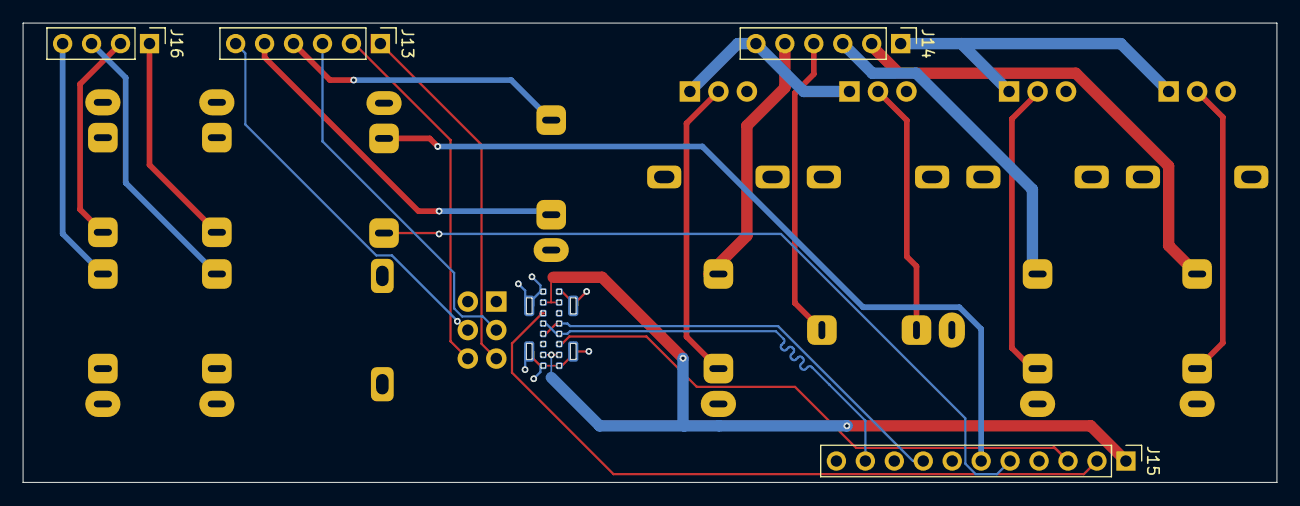
[picture p17: board fieldbox_controls.kicad_pcb from below]

Board: 4 copper layers, 110.0 x 40.3 mm, 20 parts (4 on the bottom side), 29 nets.
